ksflores-cmyk/PCIe808_SW/bom/BOM_PI7C9X3G808GP.xlsx

Sheet: BOM
Item | Categoria | Designators | Cant/placa | Descripcion | Footprint | Fabricante | MPN | Proveedor | PN proveedor | LCSC PN | Clase JLCPCB | Stock | USD unit (1 placa) | USD ext (1 placa) | USD unit (5 placas) | USD ext (5 placas) | GTQ unit (1 placa) | GTQ ext (1 placa) | GTQ ext (5 placas) | Alterno 1 (AVL) | Alterno 2 (AVL) | Estado | Confianza | Notas | URL
A01 | IC | U5 | 1 | Switch PCIe Gen3 8 puertos/8 lanes PI7C9X3G808GP | HFCBGA-196 15x15mm | Diodes Incorporated | PI7C9X3G808GPCHFCEX | DigiKey | 31-PI7C9X3G808GPCHFCEXTR-ND |  | NoEnBiblioteca | 2400 | $53.7000 | $53.70 | $53.7000 | $268.50 | Q 410.370 | Q 410.37 | Q 2051.85 |  |  | POBLADO | ALTA | RIESGO: Diodes publico PCN-2740 (EOL, 2025-06-16; ultima compra BHFCEX 2025-12-16). El sufijo CHFCEX sigue activo; DigiKey: stock de fabrica 800-2400, lead time 39 semanas, aprox. $53.70 c/u. Comprar con anticipacion; sin alterno pin-compatible. | https://www.digikey.com/en/products/detail/diodes-incorporated/PI7C9X3G808GPCHFCEX/22158428
A02 | IC | U1 | 1 | Buck TPS54KB20RZR (TI) - convertidor disenado con WEBENCH | TI RZR0016A (VQFN-HR 16) | Texas Instruments | TPS54KB20RZRR | DigiKey | 296-TPS54KB20RZRRCT-ND |  | NoEnBiblioteca | 3939 | $5.0300 | $5.03 | $5.0300 | $25.15 | Q 38.439 | Q 38.44 | Q 192.19 |  |  | POBLADO | ALTA | NOTA DE MPN: El simbolo usa TPS54KB20RZR (RZR es el codigo de paquete), pero el MPN ordenable real en TI y DigiKey lleva doble R final: TPS54KB20RZRR (RZR + R de Tape & Reel / Cut Tape). En TI Store (https://www.ti.com/product/TPS54KB20/part-details/TPS54KB20RZRR) cuesta $4.026 (1-99 uds). En DigiKey: 1-9 uds $5.03, 10+ $3.827. | https://www.digikey.com/en/products/detail/texas-instruments/TPS54KB20RZRR/22539602
A03 | IC | U2 | 1 | Buck TPS54J060RPGR (TI) - convertidor disenado con WEBENCH | TI RPG0014A (VQFN-HR 14) | Texas Instruments | TPS54J060RPGR | DigiKey | 296-TPS54J060RPGRCT-ND |  | NoEnBiblioteca | 1129 | $2.8060 | $2.81 | $2.8060 | $14.03 | Q 21.443 | Q 21.44 | Q 107.22 |  |  | POBLADO | ALTA | Stock inmediato en DigiKey: 1129 uds (escalon 10+ en DigiKey: $2.73700; en TI Store https://www.ti.com/product/TPS54J060/part-details/TPS54J060RPGR el precio de 1-99 uds es $2.806). NO sustituir. | https://www.digikey.com/en/products/detail/texas-instruments/TPS54J060RPGR/15856949
A04 | IC | U7 | 1 | Buck TPS62933FDRLR (TI) - convertidor disenado con WEBENCH | TI DRL0008A (SOT-583 8) | Texas Instruments | TPS62933FDRLR | DigiKey | 296-TPS62933FDRLRCT-ND |  | NoEnBiblioteca | 2819 | $1.7000 | $1.70 | $1.7000 | $8.50 | Q 12.991 | Q 12.99 | Q 64.96 |  |  | POBLADO | ALTA | Stock inmediato en DigiKey: 2819 uds ($1.70 para 1-9 uds, $1.242 para 10+ uds; en TI Store https://www.ti.com/product/TPS62933F/part-details/TPS62933FDRLR cuesta $1.241 de 1-99 uds). La letra F indica operacion en modo FCCM continuo; NO sustituir por variantes DRLR/ODRLR/PDRLR. | https://www.digikey.com/en/products/detail/texas-instruments/TPS62933FDRLR/16669312
A05 | IC | U3 U6 | 2 | LDO AP7361C-FGE-7 (Diodes Inc.) | DFN-8 3x3mm 0.65mm | Diodes Incorporated | AP7361C-FGE-7 | DigiKey | AP7361C-FGE-7DICT-ND |  | NoEnBiblioteca | 61948 | $0.5600 | $1.12 | $0.3027 | $3.03 | Q 4.279 | Q 8.56 | Q 23.13 |  |  | POBLADO | ALTA | Amplio stock en DigiKey (61,948 uds) y Mouser (26,023 uds, https://www.mouser.com/ProductDetail/Diodes-Incorporated/AP7361C-FGE-7). Para 1 placa (2 uds) aplica escalon 1+ ($0.56); para 5 placas (10 uds) alcanza el escalon 10+ ($0.3027). | https://www.digikey.com/en/products/detail/diodes-incorporated/AP7361C-FGE-7/5638318
A06 | IC | U4 | 1 | Hex buffer open-drain SN74LVC07A | TSSOP-14 0.65mm | Nexperia | 74LVC07APW,118 | DigiKey | 1727-74LVC07APW,118CT-ND |  | NoEnBiblioteca | 4543 | $0.2500 | $0.25 | $0.2500 | $1.25 | Q 1.910 | Q 1.91 | Q 9.55 | Texas Instruments SN74LVC07APWR (DigiKey 0 en stock, llegan 2026-11-10; TI Store ~$0.37) | Diodes Inc. 74LVC07AT14-13 (DigiKey, $0.25) | POBLADO | ALTA | Cambio: el MPN original SN74LVC07APWR tenia 0 en stock; esta pieza es pin-compatible (TSSOP-14, hex buffer open-drain, 1.65-5.5 V). | https://www.digikey.com/en/products/detail/texas-instruments/SN74LVC07APWR/377393
A07 | IC | U8 U9 | 2 | Compuerta AND 2 entradas SN74LVC1G08 | SOT-23-5 (DBV) | Texas Instruments | SN74LVC1G08DBVR | LCSC | C7666 | C7666 | Extended | 95328 | $0.0338 | $0.07 | $0.0338 | $0.34 | Q 0.258 | Q 0.52 | Q 2.58 | Nexperia 74LVC1G08GV,125 (DigiKey 1727-74LVC1G08GV,125CT-ND) | SIN_ALTERNO | POBLADO | ALTA |  | https://jlcpcb.com/partdetail/TexasInstruments-SN74LVC1G08DBVR/C7666
A08 | Discreto | Q1 | 1 | MOSFET N 2N7002A (SOT-23 estandar) | SOT-23 (TO-236AB) | Diodes Incorporated | 2N7002A-7 | Mouser | 621-2N7002A-7 |  | NoEnBiblioteca | 19346 | $0.2300 | $0.23 | $0.2300 | $1.15 | Q 1.758 | Q 1.76 | Q 8.79 | onsemi 2N7002KT1G (DigiKey 2N7002KT1GOSCT-ND) | High Diode 2N7002 (LCSC C466660) | POBLADO | ALTA | Pinout 2N7002A-7: 1=G, 2=S, 3=D. Verificado en Allegro: pads G (x=5857) y S (x=5783) arriba, D (x=5820) abajo = SOT-23 estandar girado 180 grados, compatible con G-S-D. Pendiente visual: confirmar Q1 en capa TOP. DigiKey en backorder, Mouser tiene 19,346 uds. | https://www.mouser.com/c/semiconductors/discrete-semiconductors/transistors/mosfets/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
A09 | Magnetico | L1 | 1 | Inductor Coilcraft XAL8080 680 nH (L1) - Buck WEBENCH | XAL8080 (8x8mm aprox.) | Coilcraft | XAL8080-681MED | Fabricante | XAL8080-681MED |  | NoEnBiblioteca | 450 | $1.6900 | $1.69 | $1.6900 | $8.45 | Q 12.915 | Q 12.91 | Q 64.57 |  |  | POBLADO | ALTA | NOTA DE SUFIJO COILCRAFT: En la pagina oficial de Coilcraft se informa que el sufijo de empaque B (XAL8080-681MEB) fue unificado al sufijo D (XAL8080-681MED: M=+-20%, E=RoHS Sn-Ag sobre Cu libre de halogenos, D=reel/corte disponible desde 1 ud). Precio directo Coilcraft: $1.69/ud (1+), $1.46/ud (2500+). | https://www.coilcraft.com/en-us/products/power/shielded-inductors/molded-inductor/xal/xal8080/xal8080-681/
A10 | Magnetico | L2 | 1 | Inductor Coilcraft XAL5020 560 nH (L2) - Buck WEBENCH | XAL5020 (5x5mm aprox.) | Coilcraft | XAL5020-561MEC | Fabricante | XAL5020-561MEC |  | NoEnBiblioteca | 344 | $0.7100 | $0.71 | $0.7100 | $3.55 | Q 5.426 | Q 5.43 | Q 27.13 |  |  | POBLADO | ALTA | NOTA DE SUFIJO COILCRAFT: Coilcraft unifico el codigo de empaque B a C (XAL5020-561MEC reemplaza a XAL5020-561MEB). Stock inmediato en Coilcraft: 344 uds listas para envio hoy + 664 uds adicionales el 2026-11-09. Precio unitario: $0.71 (1+). | https://www.coilcraft.com/en-us/products/power/shielded-inductors/molded-inductor/xal/xal5020/xal5020-561/
A11 | Magnetico | L3 | 1 | Inductor Coilcraft XAL7030 1.5 uH (L3) - Buck WEBENCH | XAL7030 (7x7mm aprox.) | Coilcraft | XAL7030-152MEC | LCSC | C5352784 | C5352784 | Extended | 8 | $3.0400 | $3.04 | $3.0400 | $15.20 | Q 23.231 | Q 23.23 | Q 116.16 | Coilcraft XAL7030-152MEC (Otro 69W4151) | SIN_ALTERNO | POBLADO | ALTA | Stock LCSC: solo 8 uds (alcanza 1 y 5 placas). Alterno: Coilcraft directo/Newark 69W4151, mismo MPN XAL7030-152MEC. Isat 23.5 A, DCR 7.6 mOhm. | https://www.lcsc.com/product-detail/power-inductors_coilcraft-xal7030-152mec_C5352784.html
A12 | Magnetico | BD1 BD2 BD3 BD4 BD5 BD6 | 6 | Ferrita HI1812V101R-10 (100 ohm @100 MHz) | 1812 (L1812) | Laird-Signal Integrity Products | HI1812V101R-10 | DigiKey | 240-2543-1-ND | C2442066 | Extended | 189703 | $0.5600 | $3.36 | $0.4500 | $13.50 | Q 4.279 | Q 25.68 | Q 103.17 | Wurth Elektronik 74279226101 (DigiKey 732-74279226101CT-ND) | Wurth Elektronik 78279226101 (DigiKey 732-78279226101CT-ND) | POBLADO | ALTA | JLCPCB/LCSC C2442066 a $0.3702 (Extended, 11,889 uds) es mas barato que DigiKey; precio mostrado = DigiKey. Alternos Wurth 100 ohm/100 MHz/8 A con menor DCR (6 mOhm). | https://www.digikey.com/en/products/detail/laird-signal-integrity-products/HI1812V101R-10/1015967
A13 | Conector | J1 J2 J3 J4 | 4 | Conector M.2 (NGFF) Key M, para SSD 2280 | M2_M_2280_KF (conector SMD 67 pos, Key M, altura a definir) | TE Connectivity | 1-2199230-4 | DigiKey | 17-1-2199230-4CT-ND |  | NoEnBiblioteca | 4248 | $1.9500 | $7.80 | $1.7910 | $35.82 | Q 14.902 | Q 59.61 | Q 273.73 | TE Connectivity 1-2199230-5 (DigiKey A115905CT-ND) | Minlenda MLD-NGFF-M-3.2H (LCSC C52766481) | POBLADO | ALTA | MPN corregido: 1-2199230-4 es Key M (SSD 2280), 4.2 mm, 10 uin Au. 2199230-4 (sin prefijo) es Key E, NO usar. Alterno JLCPCB para 3.2 mm: Minlenda MLD-NGFF-M-3.2H (C52766481); altura 4.2 mm define el standoff. | https://www.digikey.com/en/products/detail/te-connectivity-amp-connectors/1-2199230-4/7039236
A13B | Mecanico | J1 J2 J3 J4 (1 por conector, a 80 mm del conector) | 4 | Standoff SMD (poste) para modulos M.2 2280 + tornillo M2 | Standoff SMD M2, altura igual a la del conector M.2 elegido en A13 | JAE Electronics | SM3ZS067U410-NUT1-R1200 | DigiKey | 670-2865-1-ND |  | NoEnBiblioteca | 131543 | $1.2900 | $0.00 | $1.0950 | $0.00 | Q 9.858 | Q 0.00 | Q 0.00 | Wurth Elektronik 9774025243R (DigiKey 732-9774025243RCT-ND) | SIN_ALTERNO | OPCIONAL | ALTA | NO incluido en total. El footprint de J4 trae un agujero PTH de 3.2 mm con pad de 6.0 mm a la posicion 2280 (MH1) y pads SMD MP1/MP2 de 1.2x2.75 mm, no un pad SMD de standoff: la tuerca SMD JAE puede no coincidir con ese agujero. Verificar contra el plano del conector antes de comprar; es herreria opcional, no afecta el PCB. | https://www.digikey.com/en/products/detail/jae-electronics/SM3ZS067U410-NUT1-R1200/5955846
A14 | Conector | P1 | 1 | Conector de potencia 4 pines vertical/90 grados "PWR-4P-90" (P1) | PWR-4P-90 | Molex | 0015244441 | DigiKey |  |  | NoAplica |  |  | $0.00 |  | $0.00 |  | Q 0.00 | Q 0.00 | Molex 0039301040 (Mini-Fit Jr 2x2, paso 4.2 mm: NO coincide con 5.08 mm) | Molex 0022053041 (KK 254, paso 2.54 mm: NO coincide con 5.08 mm) | POR_DEFINIR | MEDIA | Medido en Allegro: P1 tiene 4 pads a 5.08 mm de paso (pads 2.54x4.00 mm), pin1=12V, pin2=GND, pin3=GND, pin4=5V. Candidato: Molex 15-24-4441 (disk power, 5.08 mm, 90 grados). Precio y PN DigiKey sin verificar; el footprint declara pads SMD y la pieza es de agujero pasante: confirmar contra el plano. Excluido del total. | https://www.digikey.com/en/products/detail/molex/0039301040/561079
A15 | Conector | PWR1 | 1 | Conector de potencia PCIe 6 pines Molex 45558-0003 (PWR1) | 455580003 | Molex | 0455580003 | DigiKey | WM10869-ND |  | NoEnBiblioteca | 74992 | $1.1700 | $1.17 | $1.1700 | $5.85 | Q 8.941 | Q 8.94 | Q 44.71 |  |  | POBLADO | ALTA | MPN confirmado en Molex y DigiKey (0455580003 = 45558-0003). Stock inmediato en DigiKey: 74,992 uds a $1.17/ud. | https://www.digikey.com/en/products/detail/molex/0455580003/3311349
A16 | LED | DS1 DS2 | 2 | LED verde 0805 | LED-0805 | Hubei KENTO Elec | KT-0805G | LCSC | C2297 | C2297 | Basic | 1977662 | $0.0164 | $0.03 | $0.0164 | $0.16 | Q 0.125 | Q 0.25 | Q 1.25 |  |  | POBLADO | ALTA | Pieza JLCPCB Basic (C2297) con 1,977,662 uds en stock ($0.0164/ud en cantidades bajas, $0.0101/ud en carrete). Verificar polaridad del catodo en el footprint LED-0805. | https://jlcpcb.com/partdetail/C2297
A17 | LED | DS3 DS4 DS5 DS6 | 4 | LED rojo 0805 | LED-0805 | Foshan NationStar Optoelectronics | NCD0805R1 | LCSC | C84256 | C84256 | Basic | 2049152 | $0.0089 | $0.04 | $0.0089 | $0.18 | Q 0.068 | Q 0.27 | Q 1.36 | Hubei KENTO Elec KT-0805R (LCSC C2295) | SIN_ALTERNO | POBLADO | ALTA |  | https://jlcpcb.com/partdetail/85425-NCD0805R1/C84256
A18 | Mecanico | TP1 TP2 TP3 TP4 | 4 | Punto de prueba TESTPIN25 (pad de cobre de 25 mil, sin pieza) | Pad desnudo 25 mil (0.635 mm) |  | (sin pieza) |  |  |  | NoAplica |  |  | $0.00 |  | $0.00 |  | Q 0.00 | Q 0.00 |  |  | SIN_PIEZA | ALTA | Test points: pad desnudo de cobre (TESTPIN25), sin componente. Excluir de pick&place. | NO_APLICABLE
B01 | Cap | C1 C2 C13 C14 C15 C16 C66 C67 C114 C115 C116 C117 C118 C119 C120 C121 | 16 | Capacitor 0.22 uF | 0402 | Samsung Electro-Mechanics | CL05B224KO5NNNC | LCSC | C16772 | C16772 | Basic | 1200932 | $0.0049 | $0.08 | $0.0049 | $0.39 | Q 0.037 | Q 0.60 | Q 3.00 | CCTC TCC0402X7R224K160AT (LCSC C696846) | FOJAN FCC0402B224K100AT (LCSC C54619721) | POBLADO | ALTA | Pieza JLCPCB Basic (C16772) con 1,200,932 uds en stock ($0.0049/ud base; $0.0033/ud en 1500+). Cumple holgadamente acople AC PCIe Gen3 (16V X7R +-10% en 0402). Alternos verificados en stock: CCTC C696846 (151,976 uds, $0.0039) y FOJAN C54619721 (3,885 uds, $0.0034). | https://jlcpcb.com/partdetail/CL05B224KO5NNNC/C16772
B02 | Cap | C74 C83 C85 C90 C97 C101 C102 C105 C108 C109 C112 | 11 | Capacitor 10 uF 6.3 V | 0402 | Samsung Electro-Mechanics | CL05A106MQ5NUNC | LCSC | C15525 | C15525 | Basic | 9522813 | $0.0257 | $0.28 | $0.0257 | $1.41 | Q 0.196 | Q 2.16 | Q 10.80 | FH (Guangdong Fenghua Advanced Tech) 0402X106M100NT (LCSC C2846677) | YAGEO CC0402MPX5R5BB106 (LCSC C1856527) | POBLADO | ALTA | Pieza JLCPCB Basic (C15525) con 9,522,813 uds en stock ($0.0257/ud base; $0.0163 en 3000+). DC bias: En encapsulado 0402, un MLCC de 10 uF 6.3V X5R retiene ~5.5-6.5 uF efectivos a 0.95 V (rieles VDDC/VP) y cae a ~2.0-2.5 uF efectivos a 3.3 V. Alterno FH C2846677 es de 10V (429,835 en stock, $0.0611). | https://jlcpcb.com/partdetail/16204-CL05A106MQ5NUNC/C15525
B03 | Cap | C72 C73 C78 C82 C84 C86 C87 C93 C103 C107 C111 | 11 | Capacitor 4.7 uF 6.3 V | 0402 | Samsung Electro-Mechanics | CL05A475MP5NRNC | LCSC | C23733 | C23733 | Basic | 2641074 | $0.0153 | $0.17 | $0.0153 | $0.84 | Q 0.117 | Q 1.29 | Q 6.43 | YAGEO CC0402MRX5R5BB475 (LCSC C106859) | CCTC TCC0402X5R475M6R3AT (LCSC C380302) | POBLADO | ALTA | Pieza JLCPCB Basic (C23733, 10V X5R) con 2,641,074 uds en stock ($0.0153/ud base; $0.0104 en 1500+). ALERTA DC BIAS: A 0.95 V retiene ~3.2-3.6 uF efectivos (~70-75%); a 1.8 V retiene ~2.4 uF efectivos; a 3.3 V cae a ~1.5 uF efectivos. Alterno Yageo C106859 (6.3V, 49,031 uds en stock, $0.0306). | https://jlcpcb.com/partdetail/CL05A475MP5NRNC/C23733
B04 | Cap | C3 C5 C7 C9 C11 C36 C44 C68 C69 C70 C113 | 11 | Capacitor 22 uF 25 V | 1206 | Samsung Electro-Mechanics | CL31A226KAHNNNE | LCSC | C12891 | C12891 | Basic | 1614768 | $0.1198 | $1.32 | $0.1198 | $6.59 | Q 0.915 | Q 10.07 | Q 50.35 | FH (Guangdong Fenghua Advanced Tech) 1206X226K250NT (LCSC C5162260) | FH (Guangdong Fenghua Advanced Tech) 1206X226M250NT (LCSC C2858005) | POBLADO | ALTA | 22 uF 25 V en 1206 a 12 V pierde capacidad por DC bias (derating); capacidad efectiva menor que la nominal. | https://jlcpcb.com/partdetail/13537-CL31A226KAHNNNE/C12891
B05 | Cap | C4 C6 C8 C10 C12 C37 C40 C41 C42 C45 C48 C49 C52 C61 C62 C64 C65 C71 C75 C76 C77 C79 C80 C81 C88 C89 C91 C92 C94 C95 C96 C98 C99 C100 C104 C106 C110 | 37 | Capacitor 0.1 uF (100 nF) | 0402 | Samsung Electro-Mechanics | CL05B104KO5NNNC | LCSC | C1525 | C1525 | Basic | 32493126 | $0.0031 | $0.11 | $0.0031 | $0.57 | Q 0.024 | Q 0.88 | Q 4.38 | Samsung Electro-Mechanics CL05B104KB54PNC (LCSC C307331) | YAGEO CC0402KRX7R6BB104 (LCSC C309458) | POBLADO | ALTA | Pieza JLCPCB Basic (C1525) con 32,493,126 uds en stock ($0.0031/ud base; $0.0020 en 3000+). Tambien existe la version Basic de 50V Samsung CL05B104KB54PNC (C307331). Nota: el alterno Yageo C309458 (97,250 en stock, $0.0019) y Murata GRM155R71A104KA01D (C71687, 9,951 en stock, $0.0130) son de 10V. | https://jlcpcb.com/partdetail/1877-CL05B104KO5NNNC/C1525
B06 | Cap | C39 C47 C63 | 3 | Capacitor 10 uF 10 V | 0603 | Samsung Electro-Mechanics | CL10A106MA8NRNC | LCSC | C96446 | C96446 | Basic | 6857661 | $0.0352 | $0.11 | $0.0352 | $0.53 | Q 0.269 | Q 0.81 | Q 4.03 | FH (Guangdong Fenghua Advanced Tech) 0603X106K160NT (LCSC C70225) | SIN_ALTERNO | POBLADO | ALTA |  | https://jlcpcb.com/partdetail/97651-CL10A106MA8NRNC/C96446
B07 | Cap | C33 C53 C54 C58 C59 C60 | 6 | Capacitor 47 uF 6.3 V | 0805 | Samsung Electro-Mechanics | CL21A476MQYNNNE | LCSC | C16780 | C16780 | Basic | 1038806 | $0.1021 | $0.61 | $0.1021 | $3.06 | Q 0.780 | Q 4.68 | Q 23.41 | CCTC TCC0805X5R476K6R3FT (LCSC C50767263) | Wurth Elektronik 885012107006 (LCSC C5553114) | POBLADO | ALTA | Pieza JLCPCB Basic (C16780) con 1,038,806 uds en stock ($0.1021/ud base; $0.0686 en 300+). Alterno CCTC C50767263 es +-10% con 15,567 uds en stock ($0.1326/ud). DC bias: Un MLCC 47 uF 6.3V en 0805 operando a 0.95 V (salida Buck C33 y filtrado VDDC/VP) retiene ~28-33 uF efectivos; a 3.3 V cae a ~10-14 uF efectivos. | https://jlcpcb.com/partdetail/17464-CL21A476MQYNNNE/C16780
B08 | Cap | C55 | 1 | Capacitor 100 pF 50 V C0G/NP0 | 0402 | FH (Guangdong Fenghua Advanced Tech) | 0402CG101J500NT | LCSC | C1546 | C1546 | Basic | 2700615 | $0.0030 | $0.003 | $0.0030 | $0.01 | Q 0.023 | Q 0.02 | Q 0.11 | Murata Electronics GRM1555C1H101JA01D (LCSC C77177) | SIN_ALTERNO | POBLADO | ALTA |  | https://jlcpcb.com/partdetail/1898-0402CG101J500NT/C1546
B09 | Cap | C20 C23 | 2 | Capacitor 1 uF 25 V | 0402 | Samsung Electro-Mechanics | CL05A105KA5NQNC | LCSC | C52923 | C52923 | Basic | 9868868 | $0.0063 | $0.01 | $0.0063 | $0.06 | Q 0.048 | Q 0.10 | Q 0.48 | FH (Guangdong Fenghua Advanced Tech) 0402X105K250NT (LCSC C967571) | CCTC TCC0402X5R105K250AT (LCSC C5359886) | POBLADO | ALTA | Pieza JLCPCB Basic (C52923) con 9,868,868 uds en stock ($0.0063/ud). Alternos verificados en JLCPCB con amplio stock: FH C967571 (97,073 uds, $0.0128) y CCTC C5359886 (1,604,590 uds, $0.0047). | https://jlcpcb.com/partdetail/53938-CL05A105KA5NQNC/C52923
B10 | Cap | C43 | 1 | Capacitor 22 nF 16 V | 0402 | FH (Guangdong Fenghua Advanced Tech) | 0402B223K500NT | LCSC | C1532 | C1532 | Basic | 550069 | $0.0049 | $0.0049 | $0.0049 | $0.02 | Q 0.037 | Q 0.04 | Q 0.19 | Samsung Electro-Mechanics CL05B223KA5VPNC (LCSC C307334) | KEMET C0402C223J5RACTU (LCSC C22413859) | POBLADO | ALTA | Pieza JLCPCB Basic (C1532, 50V X7R) con 550,069 uds en stock ($0.0049/ud base; $0.0032 en 3000+). Supera el requisito de >=16 V. | https://jlcpcb.com/partdetail/1884-0402B223K500NT/C1532
B11 | Cap | C34 | 1 | Capacitor 270 nF 10 V | 0402 | Cal-Chip Electronics, Inc. | GMC04X5R274K10NT | DigiKey | 4713-GMC04X5R274K10NT-ND |  | NoEnBiblioteca | 40000 | $0.5100 | $0.51 | $0.5100 | $2.55 | Q 3.897 | Q 3.90 | Q 19.49 | Cal-Chip Electronics, Inc. GMC04X5R274K25NT (DigiKey 4713-GMC04X5R274K25NTTR-ND) | Murata Electronics GRM155R61A274KE15D (DigiKey 490-GRM155R61A274KE15D-ND) | POBLADO | MEDIA | Valor poco comun (270 nF, 10 V X5R). Precio tomado de la version de 25 V de la misma pagina (MEDIA). | https://www.digikey.com/en/products/detail/cal-chip-electronics-inc/GMC04X5R274K10NT/27903922
B12 | Cap | C31 | 1 | Capacitor 33 nF 10 V | 0402 | CCTC | TCC0402X7R333K250AT | LCSC | C466238 | C466238 | Extended | 9714 | $0.0022 | $0.0022 | $0.0022 | $0.01 | Q 0.017 | Q 0.02 | Q 0.08 | Murata Electronics GCM155R71H333KE02D (LCSC C126535) | FOJAN FCC0402B333K160AT (LCSC C5137555) | POBLADO | ALTA | En stock en JLCPCB: CCTC C466238 (25V X7R +-10%, 9,714 uds, $0.0022/ud base; $0.0014 en 3000+) y alterno automotriz Murata GCM155R71H333KE02D (C126535, 50V X7R +-10%, 24,351 uds en stock, $0.0203/ud). | https://jlcpcb.com/partdetail/CCTC-TCC0402X7R333K250AT/C466238
B13 | Cap | C24 C25 C51 | 3 | Capacitor 100 nF 25 V | 0603 | YAGEO | CC0603KRX7R9BB104 | LCSC | C14663 | C14663 | Basic | 34214040 | $0.0155 | $0.05 | $0.0155 | $0.23 | Q 0.118 | Q 0.36 | Q 1.78 | Samsung Electro-Mechanics CL10B104KB8NNNC (LCSC C1591) | FH (Guangdong Fenghua Advanced Tech) 0603B104K500NT (LCSC C30926) | POBLADO | ALTA | Pieza JLCPCB Basic (C14663, 50V X7R) con 34,214,040 uds en stock ($0.0155/ud base; $0.0102 en 1500+). Alternos verificados con millones en stock: Samsung C1591 (50V, 3,404,212 uds, $0.0071), Samsung C1590 (25V, 501,553 uds, $0.0143) y FH C30926 (50V, 4,235,600 uds, $0.0049). | https://jlcpcb.com/partdetail/Yageo-CC0603KRX7R9BB104/C14663
B14 | Cap | C17 | 1 | Capacitor 330 nF 10 V | 0603 | FH (Guangdong Fenghua Advanced Tech) | 0603B334K250NT | LCSC | C1615 | C1615 | Extended | 102029 | $0.0169 | $0.02 | $0.0169 | $0.08 | Q 0.129 | Q 0.13 | Q 0.65 | YAGEO CC0603KRX7R8BB334 (LCSC C107070) | Kyocera AVX 06035C334KAT2A (LCSC C5372022) | POBLADO | ALTA | Disponibilidad confirmada en 0603 X7R 25V: FH C1615 tiene 102,029 uds en stock en JLCPCB ($0.0169/ud) y el alterno Yageo CC0603KRX7R8BB334 (C107070) tiene 63,069 uds en stock ($0.0155/ud). Evitar CCTC C48986350 porque solo tiene 4 uds en stock. | https://jlcpcb.com/partdetail/1967-0603B334K250NT/C1615
B15 | Cap | C26 C32 | 2 | Capacitor 100 nF 25 V | 0805 | YAGEO | CC0805KRX7R9BB104 | LCSC | C49678 | C49678 | Basic | 28065147 | $0.0206 | $0.04 | $0.0206 | $0.21 | Q 0.157 | Q 0.31 | Q 1.57 | Samsung Electro-Mechanics CL21B104KCFNNNE (LCSC C28233) | CCTC TCC0805X7R104K101DTM (LCSC C51902255) | POBLADO | ALTA | Pieza JLCPCB Basic (C49678, 50V X7R) con 28,065,147 uds en stock ($0.0206/ud base; $0.0155 en 200+). Alternos verificados: Samsung C28233 (100V X7R, 3,273,359 uds en stock, $0.0185) y CCTC C51902255 (100V X7R, 7,670 uds, $0.0309). | https://jlcpcb.com/partdetail/YAGEO-CC0805KRX7R9BB104/C49678
B16 | Cap | C50 | 1 | Capacitor 10 uF 10 V X5R | 0805 | Samsung Electro-Mechanics | CL21A106KAYNNNE | LCSC | C15850 | C15850 | Basic | 7304027 | $0.0397 | $0.04 | $0.0397 | $0.20 | Q 0.303 | Q 0.30 | Q 1.52 | CCTC TCC0805X5R106K160FT (LCSC C380332) | FH (Guangdong Fenghua Advanced Tech) 0805X106K250NT (LCSC C40894) | POBLADO | ALTA | Pieza JLCPCB Basic (C15850, 25V X5R +-10%) con 7,304,027 uds en stock ($0.0397/ud base; $0.0313 en 200+). Alternos en stock: CCTC C380332 (16V, 65,691 uds, $0.0351) y FH C40894 (25V, 244,723 uds, $0.1098). DC bias: En 0805 25V, a 3.3 V retiene ~6.5-7.5 uF efectivos; a 5 V retiene ~5.0-6.0 uF efectivos. | https://jlcpcb.com/partdetail/16532-CL21A106KAYNNNE/C15850
B17 | Cap | C27 C38 | 2 | Capacitor 2.2 uF 10 V | 0805 | Samsung Electro-Mechanics | CL21A225KBQNNNE | LCSC | C377773 | C377773 | Basic | 795697 | $0.0393 | $0.08 | $0.0393 | $0.39 | Q 0.300 | Q 0.60 | Q 3.00 | FH (Guangdong Fenghua Advanced Tech) 0805X225K250NT (LCSC C105486) | CCTC TCC0805X7R225K160FT (LCSC C380348) | POBLADO | ALTA | Pieza JLCPCB Basic (C377773, 50V X5R) con 795,697 uds en stock ($0.0393/ud base; $0.0287 en 300+). Evitar CCTC C380348 porque solo tiene 4 uds en stock. | https://jlcpcb.com/partdetail/350246-CL21A225KBQNNNE/C377773
B18 | Cap | C18 C19 C21 C22 | 4 | Capacitor 4.7 uF 50 V X7R | 1206 | FH (Guangdong Fenghua Advanced Tech) | 1206B475K500NT | LCSC | C29823 | C29823 | Basic | 690395 | $0.0697 | $0.28 | $0.0697 | $1.39 | Q 0.533 | Q 2.13 | Q 10.65 | Samsung Electro-Mechanics CL31B475KBHNNNE (LCSC C51205) | Murata Electronics GRM31CR71H475KA12K (LCSC C3843658) | POBLADO | ALTA | Excelente disponibilidad en 1206 50V X7R (capacitores de entrada de los Bucks a 12V): FH C29823 tiene 690,395 uds en stock ($0.0697/ud), con alternos Samsung C51205 y Murata C3843658. | https://jlcpcb.com/partdetail/30577-1206B475K500NT/C29823
B19 | Cap | C46 | 1 | Capacitor 100 uF 6.3 V X6S | 1210 | Samsung Electro-Mechanics | CL32A107MQVNNWE | LCSC | C16196520 | C16196520 | Extended | 2763 | $0.6969 | $0.70 | $0.6969 | $3.48 | Q 5.326 | Q 5.33 | Q 26.63 | Murata Electronics GRM32EC70J107ME15L (LCSC C393041) | CCTC TCC1210X5R107M100MT (LCSC C53327005) | POBLADO | ALTA | ALERTA NRND/STOCK EN REFERENCIA MURATA: En DigiKey, Murata GRM32ER60J107ME20L tiene 0 stock ($1.42) y su variante GRM32ER60J107ME20K (102,498 en stock en DigiKey, $1.76/ud) esta marcada como NRND (Not Recommended for New Design). En JLCPCB (clase Extended) hay excelente stock activo en Samsung CL32A107MQVNNWE (C16196520, 6.3V X5R, 2,763 uds, $0.6969), Murata GRM32EC70J107ME15L (C393041, 6.3V X7S). | https://jlcpcb.com/partdetail/17321598-CL32A107MQVNNWE/C16196520
B20 | Cap | C35 | 1 | Capacitor 22 uF 16 V X5R | 1210 | Samsung Electro-Mechanics | CL32A226MOJNNNE | LCSC | C100086 | C100086 | Extended | 448 | $0.3014 | $0.30 | $0.3014 | $1.51 | Q 2.303 | Q 2.30 | Q 11.52 | AIDE CAPACITOR 1210X5R226K350NT (LCSC C49326801) | CCTC TCC1210X5R226K250MT (LCSC C48543646) | POBLADO | ALTA | Clase Extended en JLCPCB: Samsung CL32A226MOJNNNE (C100086, 16V X5R, 448 uds en stock, $0.3014/ud) y alterno de mayor voltaje AIDE 1210X5R226K350NT (C49326801, 35V X5R +-10%, 425 uds en stock, $0.2464/ud). DC bias: En paquete 1210 a 3.3 V retiene ~14-16 uF efectivos. | https://jlcpcb.com/partdetail/101300-CL32A226MOJNNNE/C100086
B21 | Cap | C28 C29 C30 | 3 | Capacitor 47 uF 16 V X5R | 1210 | Samwha Capacitor | CS3225X5R476K160NRL | LCSC | C2918513 | C2918513 | Extended | 21763 | $0.2233 | $0.67 | $0.2233 | $3.35 | Q 1.706 | Q 5.12 | Q 25.60 | Taiyo Yuden EMK325ABJ476MM8P (LCSC C20241892) | CCTC TCC1210X5R476M160MT (LCSC C53327077) | POBLADO | ALTA | Confirmada existencia real en 1210 16V X5R: Samwha CS3225X5R476K160NRL (C2918513, +-10%) tiene 21,763 uds en stock en JLCPCB a $0.2233/ud. Alternos: Taiyo Yuden EMK325ABJ476MM8P (C20241892) y CCTC TCC1210X5R476M160MT (C53327077). DC bias: A 3.3 V (salida del Buck 1, C28..C30) retiene ~22-28 uF efectivos por unidad. | https://jlcpcb.com/partdetail/3220365-CS3225X5R476K160NRL/C2918513
B22 | Cap | C56 C57 | 2 | Capacitor 100 uF 6.3 V (NO POBLAR: prefijo X_ en el simbolo) | 1206 | HRE | CGA1206X5R107M100NT | LCSC | C6119961 | C6119961 | Extended | 36921 | $0.1929 | $0.00 | $0.1929 | $0.00 | Q 1.474 | Q 0.00 | Q 0.00 | Samsung Electro-Mechanics CL31A107MQHNNWE (DigiKey 1276-CL31A107MQHNNWETR-ND) | TDK Corporation C3216X5R0J107M160AB (DigiKey 445-6008-2-ND) | DNP | ALTA | NO POBLAR (DNP). Pieza clase Extended en JLCPCB: HRE CGA1206X5R107M100NT (C6119961, 100uF 10V X5R 1206) tiene 36,921 uds en stock ($0.1929/ud base; $0.1491 en 50+). En DigiKey y JLCPCB, Samsung CL31A107MQHNNNE (C9900065869) y Murata GRM31CR60J107ME39K/L tienen 0 stock hoy (lead time 61 semanas); hay reemplazo activo de Samsung con 251,957 uds en stock. X_ en el simbolo (C56, C57) = no poblado. 100 uF 1206 X5R 6.3 V: considerar derating por DC bias. | https://jlcpcb.com/partdetail/HRE-CGA1206X5R107M100NT/C6119961
B30 | Res | R1 R2 R3 R21 R25 R26 R29 R30 R31 R32 R33 R36 R45 R46 R47 R48 R49 R51 R52 | 19 | Resistencia 0 ohm (puente) | 0402 | UNI-ROYAL (Uniroyal Elec) | 0402WGF0000TCE | LCSC | C17168 | C17168 | Basic | 14154629 | $0.0011 | $0.02 | $0.0011 | $0.10 | Q 0.008 | Q 0.16 | Q 0.80 | YAGEO AC0402JR-070RL (LCSC C138289) | FH (Guangdong Fenghua Advanced Tech) RC-02000FT (LCSC C140225) | POBLADO | ALTA | Pieza JLCPCB Basic (C17168) con 14,154,629 uds en stock ($0.0011/ud base; $0.0007 en 3000+). Alternos con >1M en stock: Yageo AC0402JR-070RL (C138289, 1,905,830 uds) y FH RC-02000FT (C140225, 1,225,937 uds). | https://jlcpcb.com/partdetail/C17168
B31 | Res | R38 | 1 | Resistencia 4.7 kohm | 0402 | UNI-ROYAL (Uniroyal Elec) | 0402WGF4701TCE | LCSC | C25900 | C25900 | Basic | n/v | $0.0014 | $0.0014 | $0.0014 | $0.01 | Q 0.011 | Q 0.01 | Q 0.05 | SIN_ALTERNO | SIN_ALTERNO | POBLADO | ALTA | Pieza JLCPCB Basic (C25900). 4.7 kohm limita el LED de 12 V a ~2 mA y ~21 mW, dentro de los 62.5 mW del 0402. | https://jlcpcb.com/partdetail/0402WGF4701TCE/C25900
B32 | Res | R28 R34 R39 R40 R41 RD6 RD8 RD10 RD11 RD12 RD13 RD14 RD15 RD16 RD17 RD18 | 16 | Resistencia 330 ohm | 0402 | UNI-ROYAL (Uniroyal Elec) | 0402WGF3300TCE | LCSC | C25104 | C25104 | Basic | 2167998 | $0.0011 | $0.02 | $0.0011 | $0.09 | Q 0.008 | Q 0.13 | Q 0.67 |  |  | POBLADO | ALTA | Pieza JLCPCB Basic (C25104) con 2,167,998 uds en stock ($0.0011/ud base; $0.0008 en 3000+). | https://jlcpcb.com/partdetail/25847-0402WGF3300TCE/C25104
B33 | Res | R14 R15 R16 R17 R24 R42 RP1 RP2 RP3 RP4 RP5 RP6 RP7 RP8 RP9 RP10 RP11 RP12 RP13 RP14 RP15 | 21 | Resistencia 5.1 kohm | 0402 | UNI-ROYAL (Uniroyal Elec) | 0402WGF5101TCE | LCSC | C25905 | C25905 | Basic | 5060970 | $0.0023 | $0.05 | $0.0023 | $0.24 | Q 0.018 | Q 0.37 | Q 1.85 |  |  | POBLADO | ALTA | Pieza JLCPCB Basic (C25905) con 5,060,970 uds en stock ($0.0023/ud base; $0.0015 en 3000+). | https://jlcpcb.com/partdetail/0402WGF5101TCE/C25905
B34 | Res | R11 R12 | 2 | Resistencia 680 ohm | 0402 | UNI-ROYAL (Uniroyal Elec) | 0402WGF6800TCE | LCSC | C25130 | C25130 | Basic | 691 | $0.0015 | $0.003 | $0.0015 | $0.01 | Q 0.011 | Q 0.02 | Q 0.11 | YAGEO RC0402FR-07680RL (LCSC C137948) | SIN_ALTERNO | POBLADO | ALTA |  | https://jlcpcb.com/partdetail/25873-0402WGF6800TCE/C25130
B35 | Res | R22 R35 | 2 | Resistencia 20 kohm 1% | 0402 | UNI-ROYAL (Uniroyal Elec) | 0402WGF2002TCE | LCSC | C25765 | C25765 | Basic | 2868709 | $0.0011 | $0.0022 | $0.0011 | $0.01 | Q 0.008 | Q 0.02 | Q 0.08 |  |  | POBLADO | ALTA | Pieza JLCPCB Basic (C25765) con 2,868,709 uds en stock ($0.0007/ud en 3000+). | https://jlcpcb.com/partdetail/26508-0402WGF2002TCE/C25765
B36 | Res | R37 | 1 | Resistencia 25 kohm 1% | 0402 | Vishay | CRCW040224K9FKTE | LCSC | C4229427 | C4229427 | Extended |  |  | $0.00 |  | $0.00 |  | Q 0.00 | Q 0.00 | Vishay PNM0402E2502BST1 25.0 k 0.1% (LCSC C4219672, $3.3672 c/u, stock 176) |  | POBLADO | MEDIA | 25.0 kohm no es valor E96. Se usa 24.9 kohm 1% (-0.4% del nominal, dentro de tolerancia). Precio de C4229427 sin verificar (resistencia 0402 comun, centavos). Si el profesor exige 25.0 k exacto, usar el alterno de $3.37. | https://jlcpcb.com/partdetail/VishayIntertech-PNM0402E2502BST1/C4219672
B37 | Res | R23 | 1 | Resistencia 3.9 kohm 1% | 0402 | ROHM Semiconductor | MCR01MZPF3901 | LCSC | C525581 | C525581 | Extended | 1540 | $0.0028 | $0.0028 | $0.0028 | $0.01 | Q 0.021 | Q 0.02 | Q 0.11 |  |  | POBLADO | ALTA | En stock en JLCPCB: ROHM MCR01MZPF3901 (C525581, 1,540 uds en stock, $0.0028/ud). | https://jlcpcb.com/partdetail/ROHMSemicon-MCR01MZPF3901/C525581
B38 | Res | R50 | 1 | Resistencia 200 ohm 1% | 0402 | UNI-ROYAL (Uniroyal Elec) | 0402WGF2000TCE | LCSC | C25087 | C25087 | Basic | 1754698 | $0.0029 | $0.0029 | $0.0029 | $0.01 | Q 0.022 | Q 0.02 | Q 0.11 |  |  | POBLADO | ALTA | Pieza JLCPCB Basic (C25087) con 1,754,698 uds en stock ($0.0029/ud base; $0.0019 en 3000+). | https://jlcpcb.com/partdetail/25830-0402WGF2000TCE/C25087
B39 | Res | R6 | 1 | Resistencia 100 kohm 1% | 0402 | UNI-ROYAL (Uniroyal Elec) | 0402WGF1003TCE | LCSC | C25741 | C25741 | Basic | 7345955 | $0.0014 | $0.0014 | $0.0014 | $0.01 | Q 0.011 | Q 0.01 | Q 0.05 | YAGEO RC0402FR-07100KL (LCSC C60491) | TyoHM RMC 0402 100K F N (LCSC C269673) | POBLADO | ALTA | Pieza JLCPCB Basic (C25741) con 7,345,955 uds en stock ($0.0010 en 3000+). Alterno Yageo RC0402FR-07100KL (C60491) tiene 15,851,079 uds en stock ($0.0021/ud). | https://jlcpcb.com/partdetail/0402WGF1003TCE/C25741
B40 | Res | R20 | 1 | Resistencia 10 kohm 0.1% | 0402 | YAGEO | RT0402BRD0710KL | LCSC | C190095 | C190095 | Extended | 427935 | $0.0255 | $0.03 | $0.0255 | $0.13 | Q 0.195 | Q 0.19 | Q 0.97 |  |  | POBLADO | ALTA | Cumple exactamente tolerancia +-0.1% y TCR +-25 ppm/C (Yageo serie RT0402). Amplio stock en JLCPCB: 427,935 uds a $0.0255/ud. | https://jlcpcb.com/partdetail/YAGEO-RT0402BRD0710KL/C190095
B41 | Res | R7 R10 R43 | 3 | Resistencia 10 kohm 1% | 0402 | UNI-ROYAL (Uniroyal Elec) | 0402WGF1002TCE | LCSC | C25744 | C25744 | Basic | 16504869 | $0.0018 | $0.01 | $0.0018 | $0.03 | Q 0.014 | Q 0.04 | Q 0.21 | YAGEO RC0402FR-0710KL (LCSC C60490) | SIN_ALTERNO | POBLADO | ALTA |  | https://jlcpcb.com/partdetail/C25744
B42 | Res | R5 | 1 | Resistencia 26.7 kohm 1% | 0402 | Ever Ohms Tech | CR0402F26K7Q10Z | LCSC | C2835756 | C2835756 | Extended | SIN_VERIFICAR_STOCK |  | $0.00 |  | $0.00 |  | Q 0.00 | Q 0.00 | YAGEO RC0402FR-0726K7L (DigiKey 311-26.7KLRCT-ND) | YAGEO AC0402FR-0726K7L (DigiKey 13-AC0402FR-0726K7LCT-ND) | POBLADO | MEDIA | Precio y stock de C2835756 sin verificar (MEDIA); disponibles Yageo RC0402FR-0726K7L y AC0402FR-0726K7L en DigiKey. Costo unitario esperado: centavos. | https://jlcpcb.com/partdetail/Ever_OhmsTech-CR0402F26K7Q10Z/C2835756
B43 | Res | R9 | 1 | Resistencia 4.99 kohm 1% | 0402 | Viking Tech | ARG02FTC4991 | LCSC | C284594 | C284594 | Extended | 9519 | $0.0050 | $0.01 | $0.0050 | $0.03 | Q 0.038 | Q 0.04 | Q 0.19 | KOA Speer Electronics, Inc. RK73H1ERTTP4991F (LCSC C2599032) | SIN_ALTERNO | POBLADO | ALTA |  | https://jlcpcb.com/partdetail/VikingTech-ARG02FTC4991/C284594
B44 | Res | R19 | 1 | Resistencia 5.49 kohm 1% | 0402 | FH (Guangdong Fenghua Advanced Tech) | RC-02K5491FT | LCSC | C324905 | C324905 | Extended | 9421 | $0.0030 | $0.003 | $0.0030 | $0.01 | Q 0.023 | Q 0.02 | Q 0.11 | GiantOhm GR0402F5K49TAG00 (LCSC C49653853) | SIN_ALTERNO | POBLADO | ALTA |  | https://jlcpcb.com/partdetail/305430-RC02K5491FT/C324905
B45 | Res | R8 | 1 | Resistencia 5.76 kohm 1% | 0402 | Vishay Intertech | CRCW04025K76FKED | LCSC | C2091613 | C2091613 | Extended | 1129 | $0.0100 | $0.01 | $0.0100 | $0.05 | Q 0.076 | Q 0.08 | Q 0.38 | Ever Ohms Tech CR0402F5K76Q10Z (LCSC C881162) | SIN_ALTERNO | POBLADO | ALTA |  | https://jlcpcb.com/partdetail/VishayIntertech-CRCW04025K76FKED/C2091613
B46 | Res | R13 | 1 | Resistencia 665 ohm 0.1% | 0402 | Vishay Intertech | TNPW0402665RBEED | LCSC | C2083064 | C2083064 | Extended | SIN_VERIFICAR_STOCK |  | $0.00 |  | $0.00 |  | Q 0.00 | Q 0.00 | Susumu RG1005V-6650-B-T5 (DigiKey RG1005V-6650-B-T5CT-ND) | TE Connectivity Passive Product RN73C1E665RBTG (DigiKey RN73C1E665RBTGCT-ND) | POBLADO | MEDIA | Precio y stock de C2083064 sin verificar (MEDIA). Exigir +-25 ppm/C: descartar KOA RN731ETTP6650B50 (50 ppm/C). Costo esperado: centavos a pocos centavos. | https://jlcpcb.com/partdetail/VishayIntertech-TNPW0402665RBEED/C2083064
B47 | Res | R44 | 1 | Resistencia 1.87 kohm 1% | 0603 | YAGEO | RT0603FRE071K87L | DigiKey | 13-RT0603FRE071K87LCT-ND |  | NoEnBiblioteca | 27026 | $0.0094 | $0.01 | $0.0094 | $0.05 | Q 0.072 | Q 0.07 | Q 0.36 | Vishay Dale CRCW06031K87FKEA (DigiKey 541-1.87KHCT-ND) | YAGEO RT0603WRC071K87L (LCSC C1720781) | POBLADO | ALTA | En DigiKey hay amplio stock inmediato: Yageo RT0603FRE071K87L (27,026 uds en stock, $0.00936/ud) y Vishay CRCW06031K87FKEA (27,519 uds en stock). En JLCPCB, Vishay CRCW06031K87FKEB (C4217238) tiene 0 stock hoy, pero existen las versiones de mayor precision Yageo RT0603WRC071K87L (C1720781, +-0.05% 15ppm) y Kamaya RMC1/16K1871DTP (C7343756, +-0.5%). | https://www.digikey.com/en/products/detail/yageo/RT0603FRE071K87L/1075184
B48 | Res | R4 | 1 | Resistencia 576 kohm 1% | 0603 | YAGEO | RC0603FR-07576KL | DigiKey | 311-576KHRCT-ND |  | NoEnBiblioteca | 10000 | $0.0100 | $0.01 | $0.0100 | $0.05 | Q 0.076 | Q 0.08 | Q 0.38 | ROHM Semiconductor MCR03ERTF5763 (DigiKey RHM576KHTR-ND) | KOA Speer Electronics, Inc. RN73R1JTTD5763F25 (DigiKey 2019-RN73R1JTTD5763F25CT-ND) | POBLADO | MEDIA | Confirmada disponibilidad inmediata en DigiKey (Buy now, ships today) en 3 fabricantes: Yageo RC0603FR-07576KL, ROHM MCR03ERTF5763 y KOA Speer RN73R1JTTD5763F25. Precio y stock exactos por confirmar en DigiKey. | https://www.digikey.com/en/products/detail/yageo/RC0603FR-07576KL/727311
B49 | Res | R27 RD1 RD2 RD3 RD4 RD5 RD7 RD9 | 8 | Resistencia 330 ohm (NO POBLAR: prefijo X_ en el simbolo) | 0402 | UNI-ROYAL (Uniroyal Elec) | 0402WGF3300TCE | LCSC | C25104 | C25104 | Basic | 2167998 | $0.0011 | $0.00 | $0.0011 | $0.00 | Q 0.008 | Q 0.00 | Q 0.00 |  |  | DNP | ALTA | X_ en simbolo (R27, RD1-RD5, RD7, RD9): no poblado (misma pieza que B32). | https://jlcpcb.com/partdetail/25847-0402WGF3300TCE/C25104
B50 | Res | R18 | 1 | Resistencia 5.1 kohm (NO POBLAR: prefijo X_ en el simbolo) | 0402 | UNI-ROYAL (Uniroyal Elec) | 0402WGF5101TCE | LCSC | C25905 | C25905 | Basic | 5060970 | $0.0023 | $0.00 | $0.0023 | $0.00 | Q 0.018 | Q 0.00 | Q 0.00 |  |  | DNP | ALTA | X_ en simbolo (R18): se asume NO poblado (misma pieza que B33). | https://jlcpcb.com/partdetail/0402WGF5101TCE/C25905

Sheet: Resumen
Resumen BOM - PI7C9X3G808GP PCIe Gen3 Switch | Kevin Flores | UNIS
Tipo de cambio GTQ por USD | 7.6419 | Referencia Banguat 2026-10-25 (Q7.6419); actualizar el dia de compra.
Concepto | 1 placa | 5 placas
Total USD (solo POBLADO con precio) | $88.29 | $432.41
Total GTQ | Q 674.73 | Q 3304.47
USD adicional si se poblaran los DNP (precio disponible) | $0.40 | $1.98
Lineas poblado / DNP / opcional-pendiente | 56 / 3 / 3
Excluido del total: A13B (standoff opcional), A14 (P1, MPN por confirmar), A18 (test points sin pieza), B36/B42/B46 (precio sin verificar), P2 (dedos PCIe, es cobre del PCB) e ID-BOARD (marca mecanica, no es pieza).
Precios unitarios segun cantidad de cada escenario (1 y 5 placas); IVA, envio y aranceles no incluidos. Fecha de consulta: 2026-11-08.

Sheet: Notas
Notas y riesgos
- A01 PI7C9X3G808GP: EOL anunciado por Diodes (PCN-2740). CHFCEX activo hoy, lead time 39 semanas, ~$53.70, sin alterno. Comprar primero.
- A06: se cambio a Nexperia 74LVC07APW,118 (4,543 en stock) porque SN74LVC07APWR tenia 0 en stock.
- A08 / Q1: pinout G-S-D verificado contra el footprint SOT23SGD_T (equivale a SOT-23 estandar girado 180 grados). Confirmar visualmente que Q1 este en TOP.
- A13 M.2: usar 1-2199230-4 (Key M). 2199230-4 es Key E. Altura 4.2 mm.
- A13B: standoff opcional; el footprint tiene agujero PTH 3.2 mm, no pad SMD.
- A14 / P1: 4 pads a 5.08 mm, 12V-GND-GND-5V. Candidato Molex 15-24-4441, sin precio ni PN verificado.
- B36: 25.0 k no es E96; se usa 24.9 k 1%. Alterno exacto Vishay 0.1% a $3.37.
- B42 y B46: existen en LCSC pero precio y stock no se verificaron.
- DNP (X_ en simbolo): B22, B49, B50. Se asumen sin poblar; fuera de los totales.
- Capacitores: B04 (22 uF 25 V) y B22 (100 uF 6.3 V) pierden capacidad por DC bias; considerar derating en el informe.
- Fuentes: DigiKey, Mouser, LCSC/JLCPCB, TE, Diodes (consulta 2026-11-08).
