ksflores-cmyk/PCIe808_SW/symbols/step/RZR0016A.stp

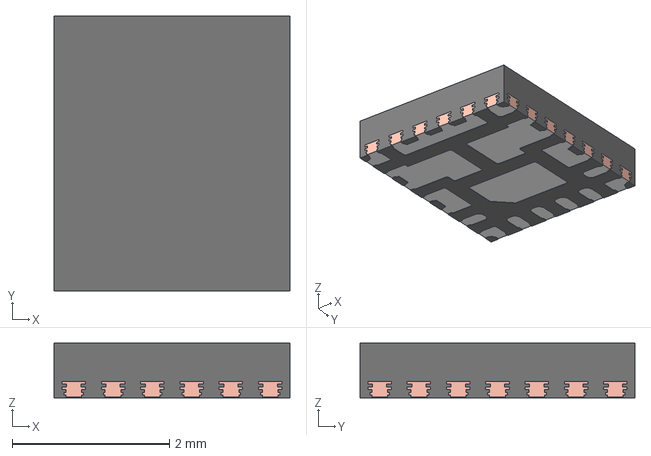
[picture p18: CAD file, 2026-10-25]
symbols/step/RZR0016A.stp
3.00 x 3.50 x 0.7 mm
RZR0016A_FRAME
RZR0016A_MOLD
