ksflores-cmyk/PCIe808_SW/symbols/step/RPG0014A.stp

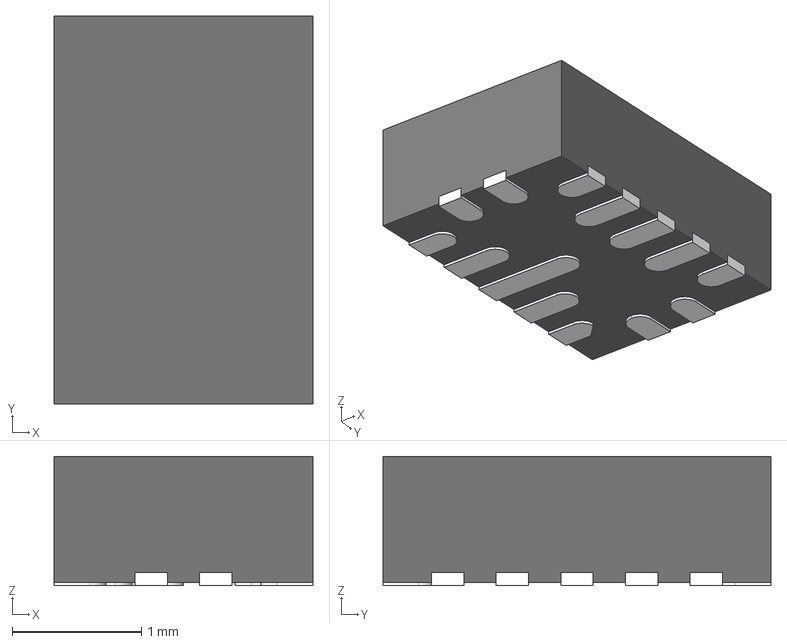
[picture p19: CAD file, 2026-10-25]
symbols/step/RPG0014A.stp
2.00 x 3.00 x 1.00 mm
FRAME
