ksflores-cmyk/PCIe808_SW/symbols/step/DRL0008A.stp

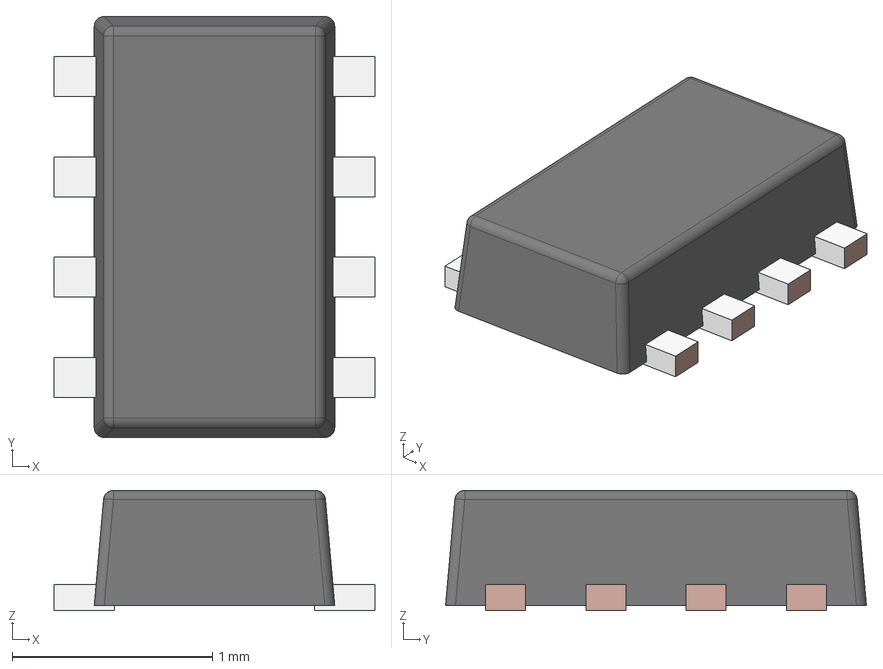
[picture p20: CAD file, 2026-10-25]
symbols/step/DRL0008A.stp
1.60 x 2.10 x 0.6 mm
FRAME-DRL0008A
BODY-SOT
