ksflores-cmyk/PCIe808_SW/(list of files, cad)

Other CAD files:
symbols/455580003.psm
symbols/blkcon100vhtm2oew20032.psm
symbols/c0402.psm
symbols/c0402_bga.psm
symbols/c0603.psm
symbols/c0805.psm
symbols/c1206.psm
symbols/c1210.psm
symbols/dfn8-0303-_65.psm
symbols/head1x3_2_54mm.psm
symbols/hfcbga_196_15x15.psm
symbols/ind_xal5020.psm
symbols/ind_xal7030.psm
symbols/ind_xal8080.psm
symbols/l1812.psm
symbols/led-0805.psm
symbols/m2_m_2280_kf.psm
symbols/pci-exp-16x.psm
symbols/pci_exp_slot_x4.psm
symbols/pci_express_x4.psm
symbols/pwr-4p-90.psm
symbols/r0402.psm
symbols/r0603.psm
symbols/rpg0014a-mfg.psm
symbols/rzr0016a-mfg.psm
symbols/soic8_1r27_kf.psm
symbols/sot23_5_kf.psm
symbols/sot23sgd_t.psm
symbols/sot5x3-8_drl_tex.psm
symbols/testpin25.psm
symbols/ti_drl0008a_kf.psm
symbols/ti_rpg0014a_kf.psm
symbols/ti_rzr0016a_kf.psm
symbols/tssop14_0r65_kf.psm
symbols/vssop8_0r5_kf.psm
