ksflores-cmyk/PCIe808_SW/outputs/PI7_KEVINFLORES_esquematico.pdf

# PCIe PI7C9X3G808GP

# UNIVERSIDAD DEL ISTMO DE GUATEMALA

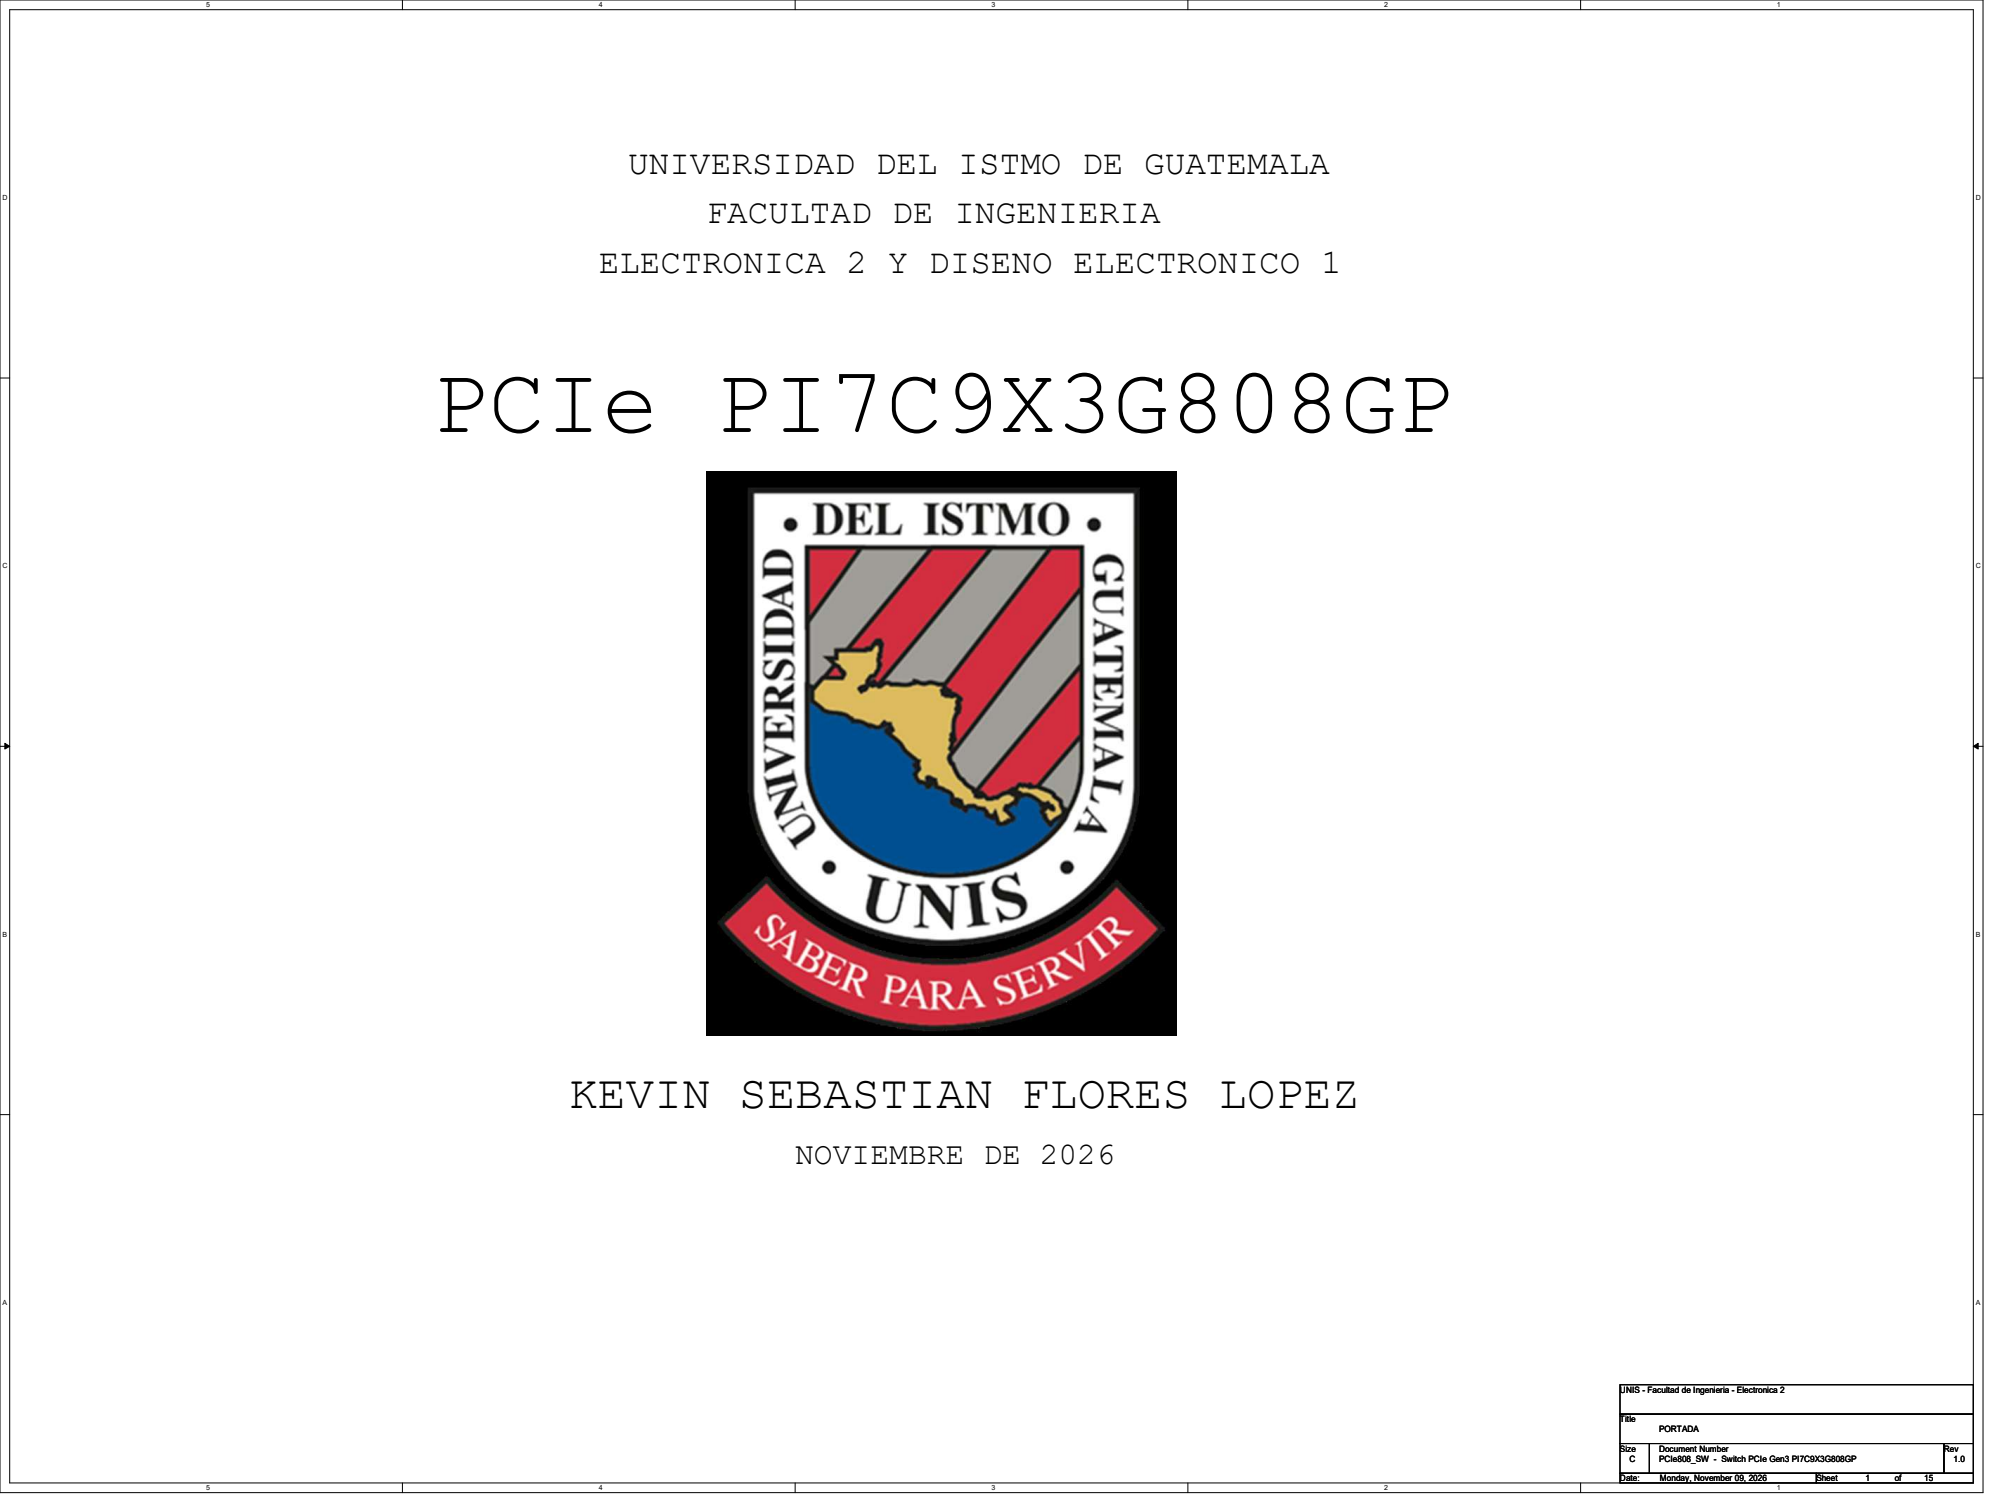
[picture p21: page 1]
NOVIEMBRE DE 2026; Title Size; Document Number; Rev Date:; Sheet; of PCIe808_SW - Switch PCIe Gen3 PI7C9X3G808GP; 1.0 PORTADA UNIS - Facultad de Ingenieria - Electronica 2 C; Monday, November 09, 2026; 15 Title Size

FACULTAD DE INGENIERIA
ELECTRONICA 2 Y DISENO ELECTRONICO 1

KEVIN SEBASTIAN FLORES LOPEZ

# INDICE DE HOJAS

Pag.

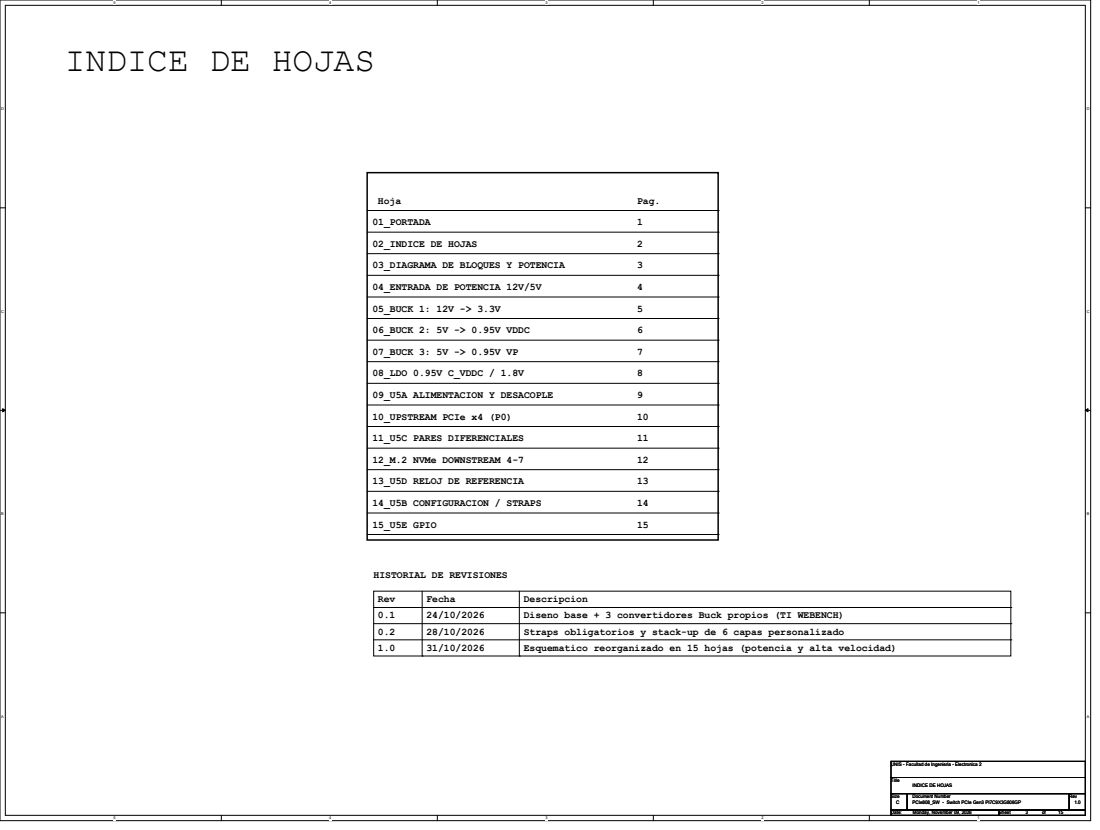
[picture p22: page 2]
Rev; Fecha; Descripcion; Diseno base + 3 convertidores Buck propios (TI WEBENCH); Straps obligatorios y stack-up de 6 capas personalizado; Esquematico reorganizado en 15 hojas (potencia y alta velocidad); 06_BUCK 2: 5V -> 0.95V VDDC; 11_U5C PARES DIFERENCIALES; 12_M.2 NVMe DOWNSTREAM 4-7; 04_ENTRADA DE POTENCIA 12V/5V; 02_INDICE DE HOJAS; 14_U5B CONFIGURACION / STRAPS; 03_DIAGRAMA DE BLOQUES Y POTENCIA; 13_U5D RELOJ DE REFERENCIA; 05_BUCK 1: 12V -> 3.3V; 01_PORTADA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

HISTORIAL DE REVISIONES

# DIAGRAMA DE BLOQUES Y ARBOL DE POTENCIA

# DIAGRAMA DE BLOQUES (SENALES)

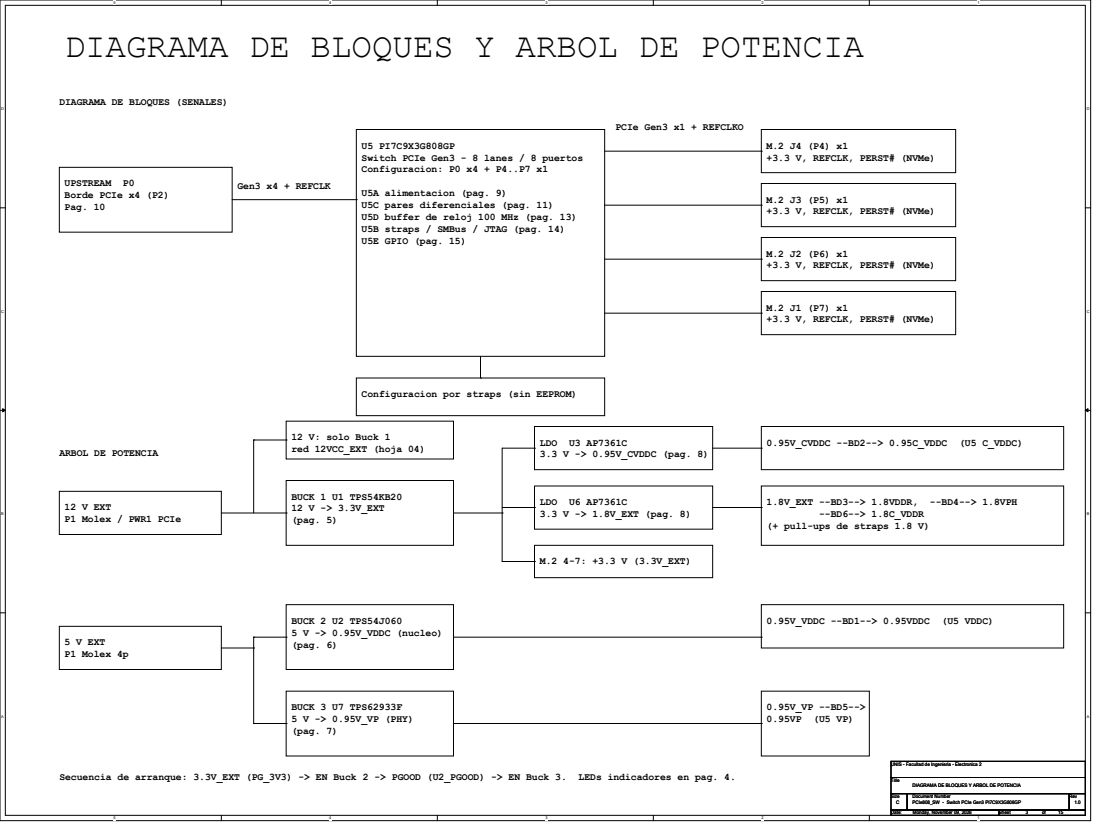
[picture p23: page 3]

U5A alimentacion (pag. 9)
U5C pares diferenciales (pag. 11)
U5D buffer de reloj 100 MHz (pag. 13)
U5B straps / SMBus / JTAG (pag. 14)
U5E GPIO (pag. 15)

Configuracion por straps (sin EEPROM)

(+ pull-ups de straps 1.8 V)

Secuencia de arranque: 3.3V_EXT (PG_3V3) -> EN Buck 2 -> PGOOD (U2_PGOOD) -> EN Buck 3. LEDs indicadores en pag. 4.

# ENTRADA DE POTENCIA 12 V / 5 V

Entrada de 12 V y 5 V externos (P1 Molex 4p / PWR1 PCIe 6p), desacople bulk, alimentacion de los Buck e indicadores LED.

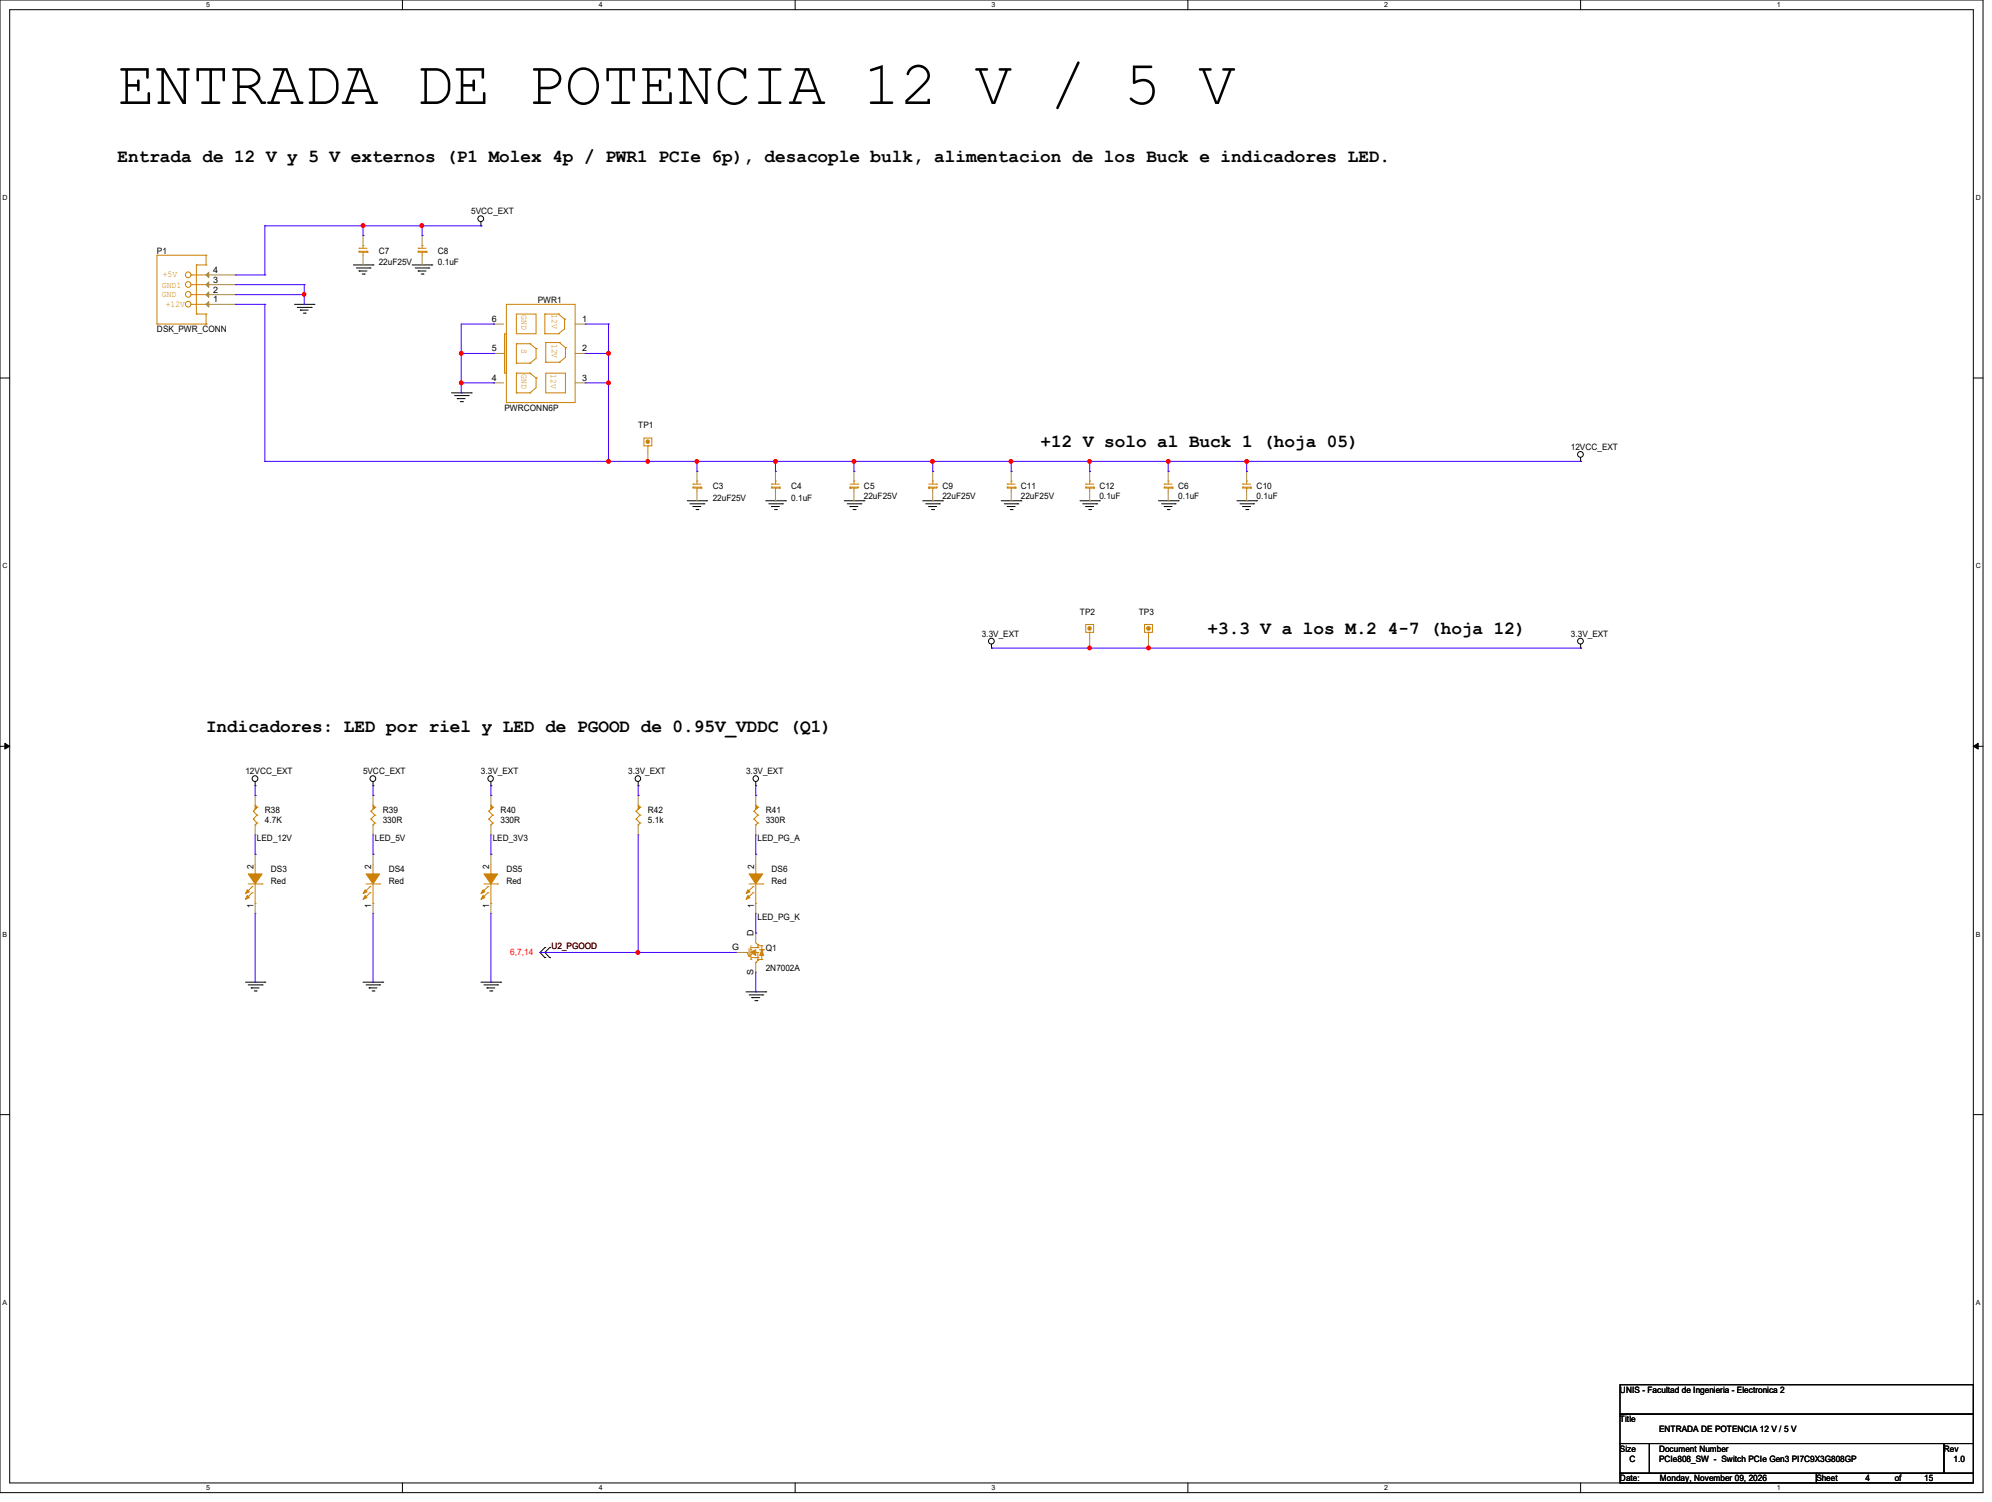
[picture p24: page 4]

+12 V solo al Buck 1 (hoja 05)

Indicadores: LED por riel y LED de PGOOD de 0.95V_VDDC (Q1)

# BUCK 1: 12 V -> 3.3 V

U1 TPS54KB20: 12 V -> 3.3V_EXT. Alimenta los 4 M.2 NVMe (hasta ~2.5 A c/u) y los LDO U3/U6. Su PG (PG_3V3) habilita el Buck 2.

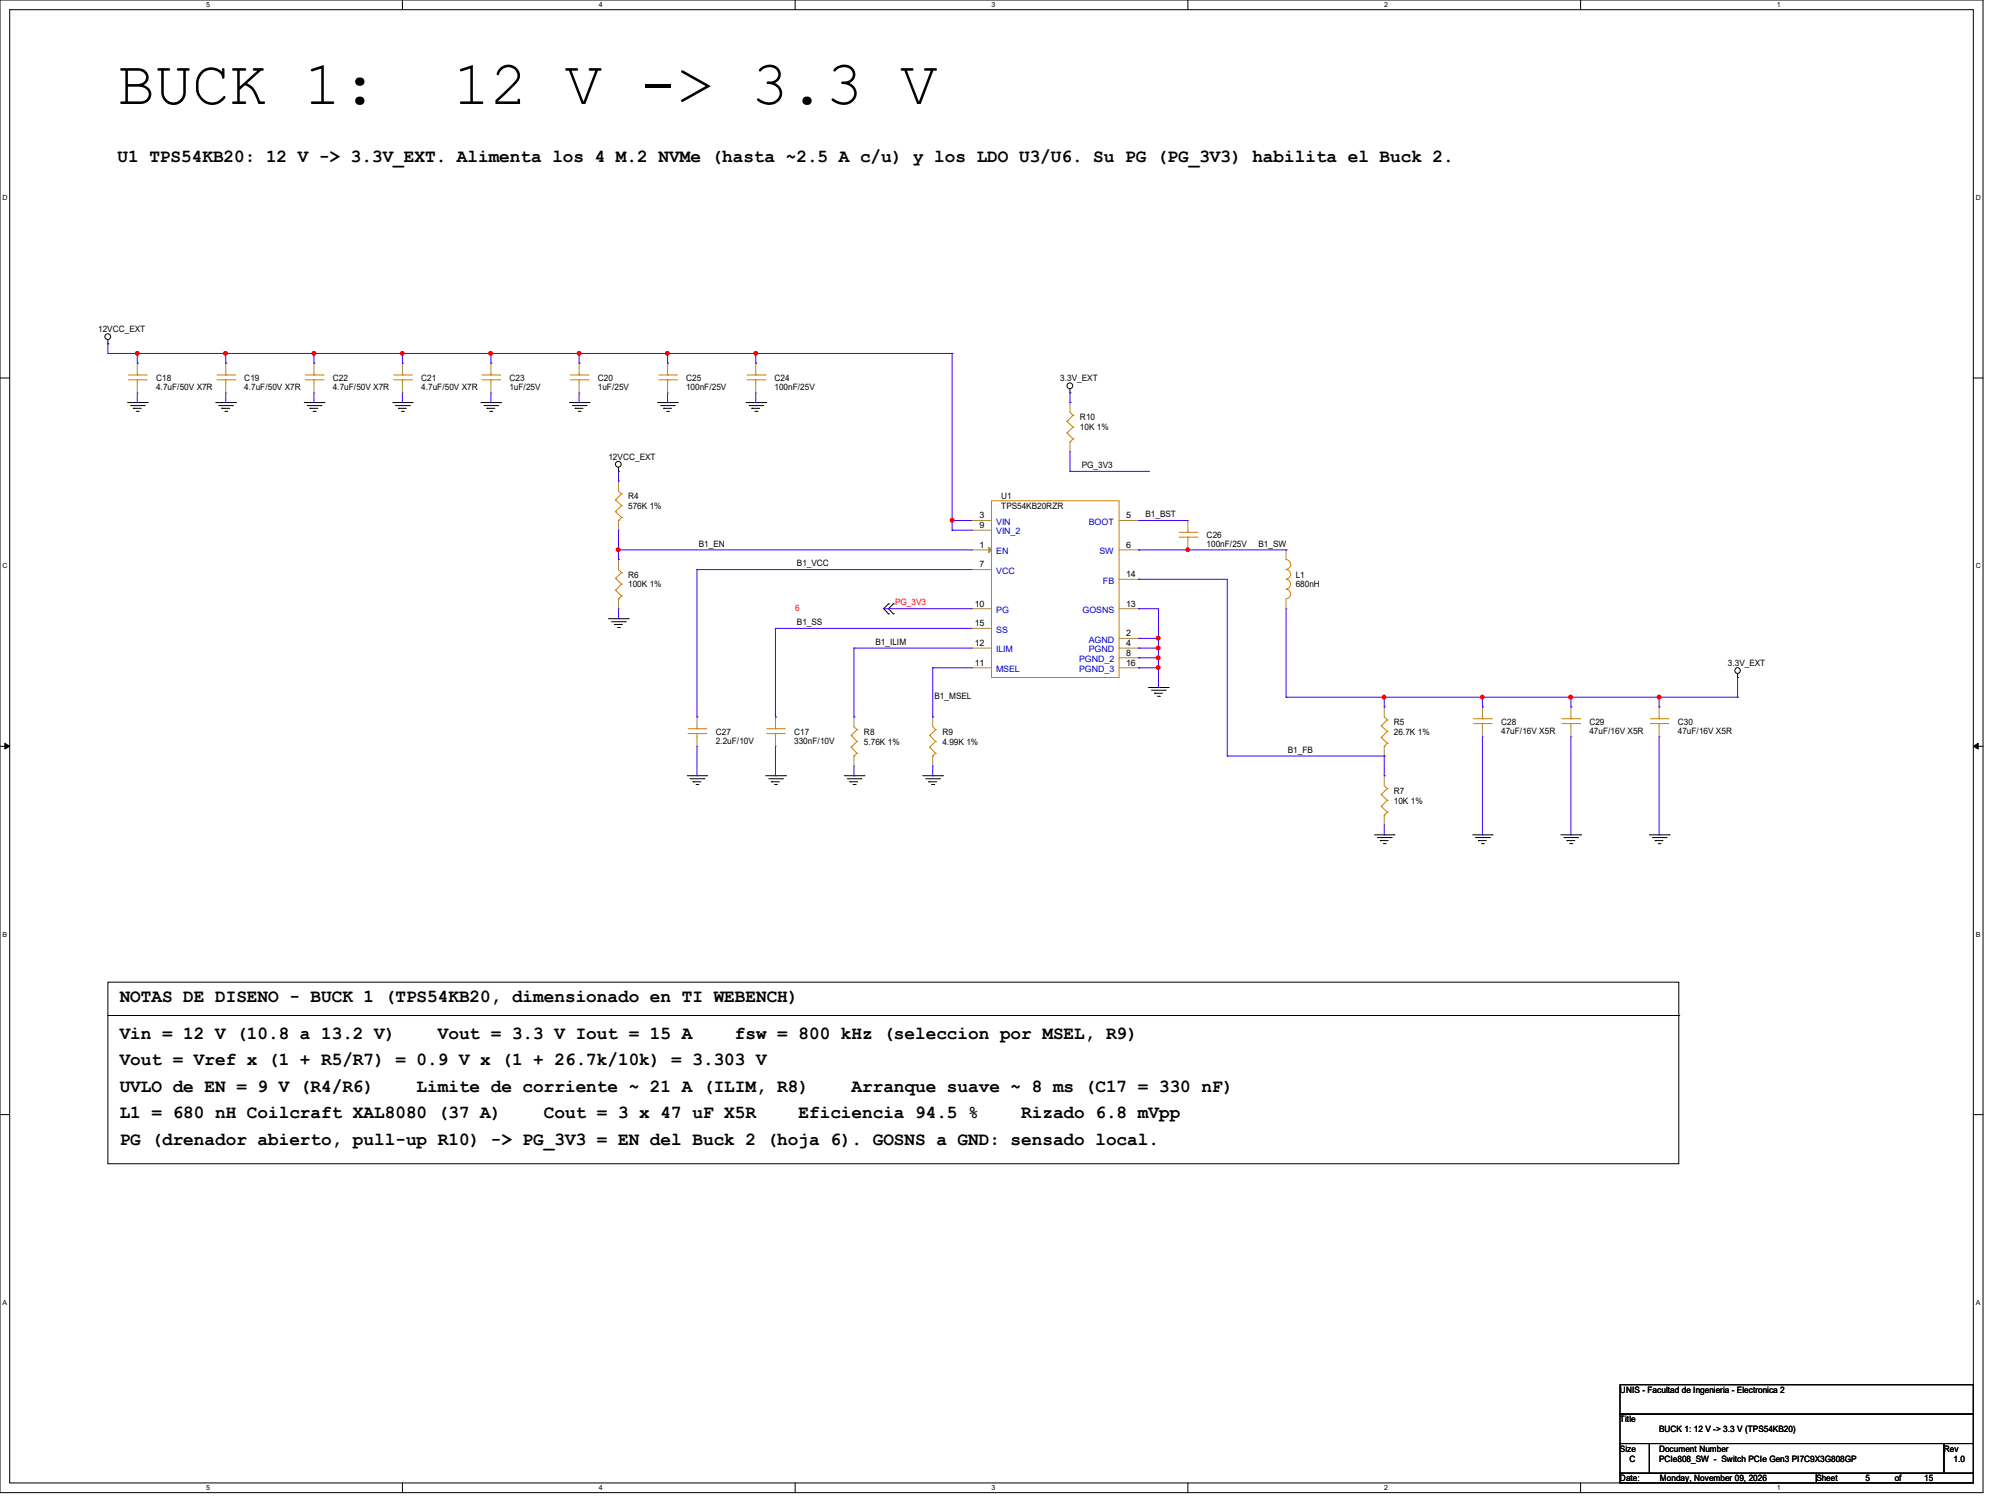
[picture p25: page 5]

NOTAS DE DISENO - BUCK 1 (TPS54KB20, dimensionado en TI WEBENCH)
Vout = Vref x (1 + R5/R7) = 0.9 V x (1 + 26.7k/10k) = 3.303 V
PG (drenador abierto, pull-up R10) -> PG_3V3 = EN del Buck 2 (hoja 6). GOSNS a GND: sensado local.

# BUCK 2: 5 V -> 0.95 V VDDC

U2 TPS54J060: 5 V -> 0.95V_VDDC (nucleo del switch). EN = PG_3V3. Su PGOOD (U2_PGOOD) habilita el Buck 3 y enciende DS6.

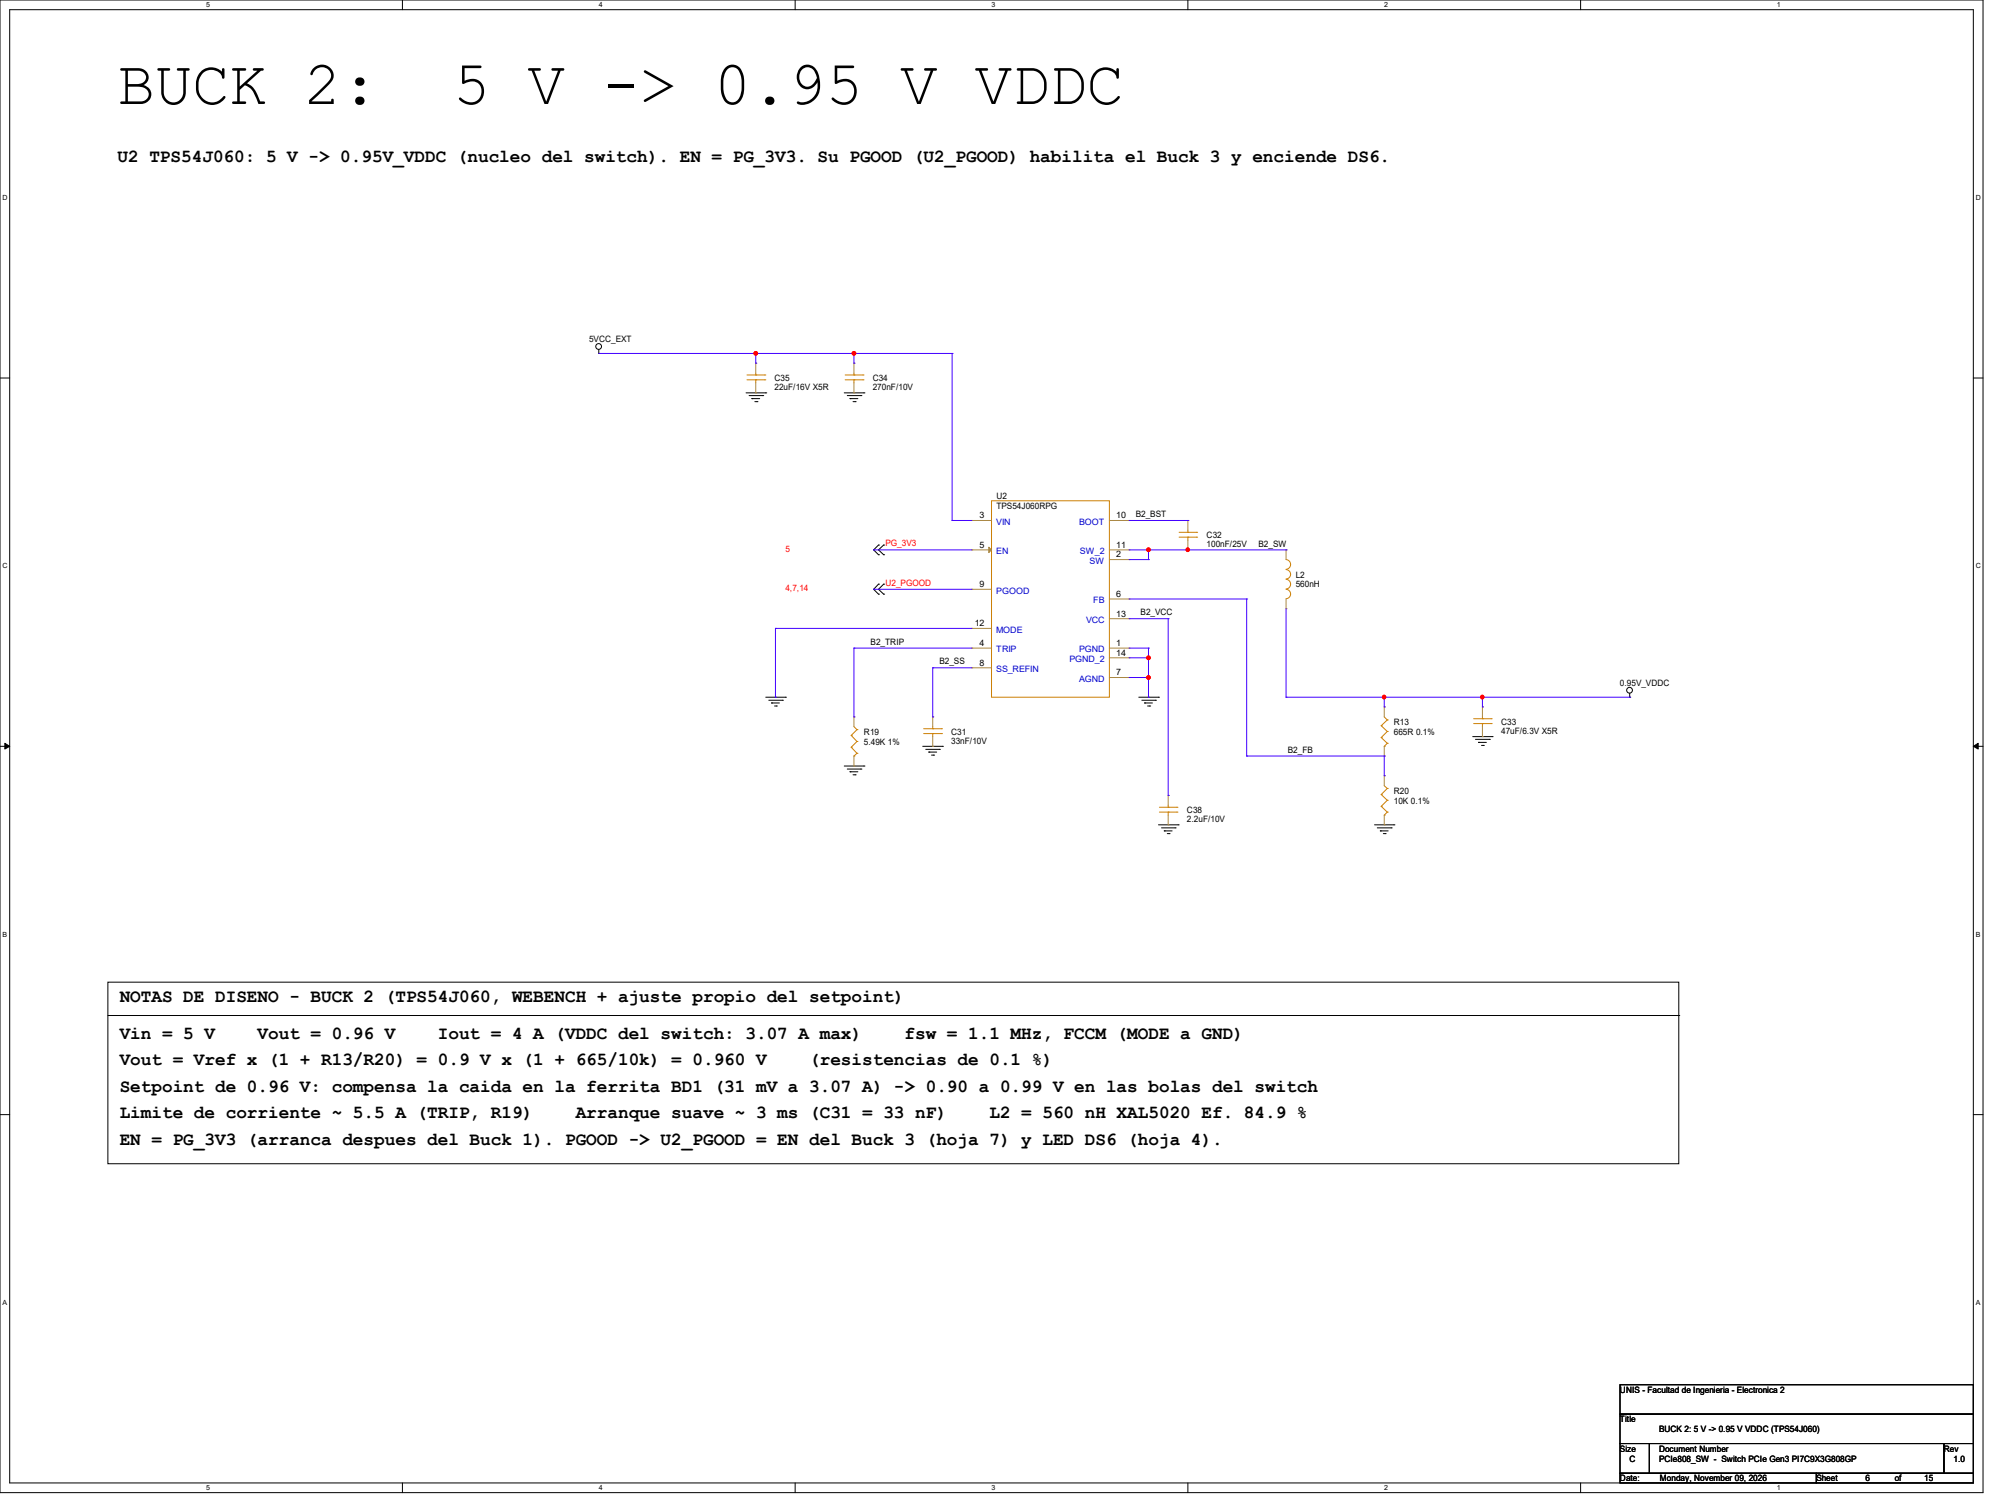
[picture p26: page 6]

NOTAS DE DISENO - BUCK 2 (TPS54J060, WEBENCH + ajuste propio del setpoint)
Setpoint de 0.96 V: compensa la caida en la ferrita BD1 (31 mV a 3.07 A) -> 0.90 a 0.99 V en las bolas del switch
EN = PG_3V3 (arranca despues del Buck 1). PGOOD -> U2_PGOOD = EN del Buck 3 (hoja 7) y LED DS6 (hoja 4).

# BUCK 3: 5 V -> 0.95 V VP

U7 TPS62933F: 5 V -> 0.95V_VP (PHY del switch). EN = U2_PGOOD. Vout = 0.8 V x (1 + R44/R43) = 0.95 V.

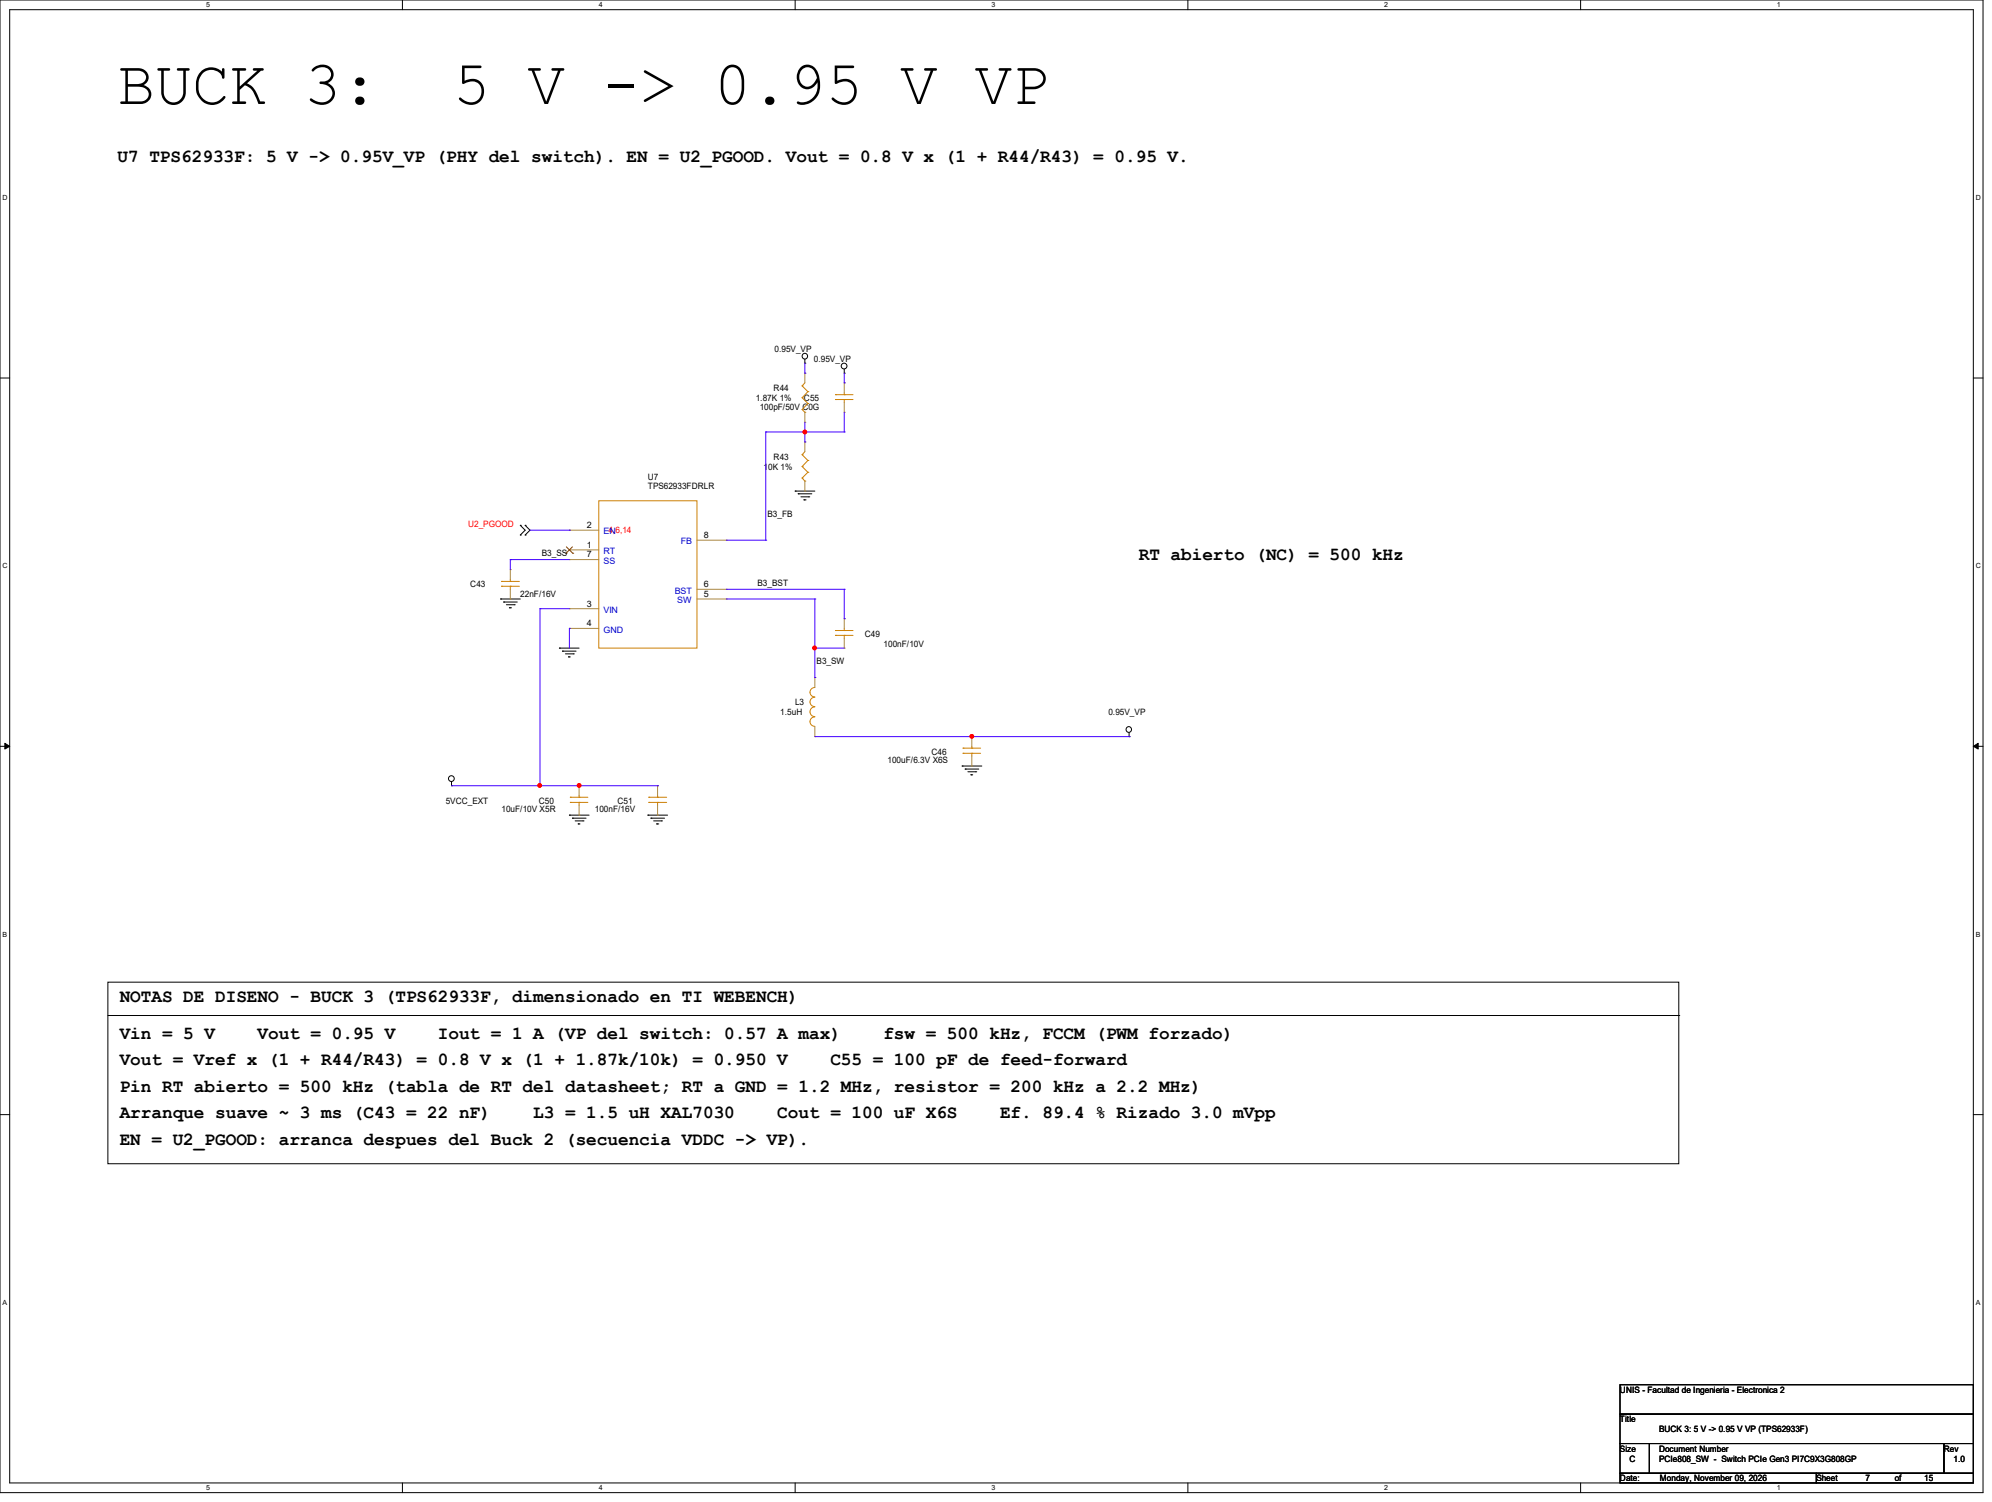
[picture p27: page 7]

RT abierto (NC) = 500 kHz

NOTAS DE DISENO - BUCK 3 (TPS62933F, dimensionado en TI WEBENCH)
Pin RT abierto = 500 kHz (tabla de RT del datasheet; RT a GND = 1.2 MHz, resistor = 200 kHz a 2.2 MHz)
EN = U2_PGOOD: arranca despues del Buck 2 (secuencia VDDC -> VP).

## R1Vout=0.8V{(R1+R2)/R2}

0.95V / 1A

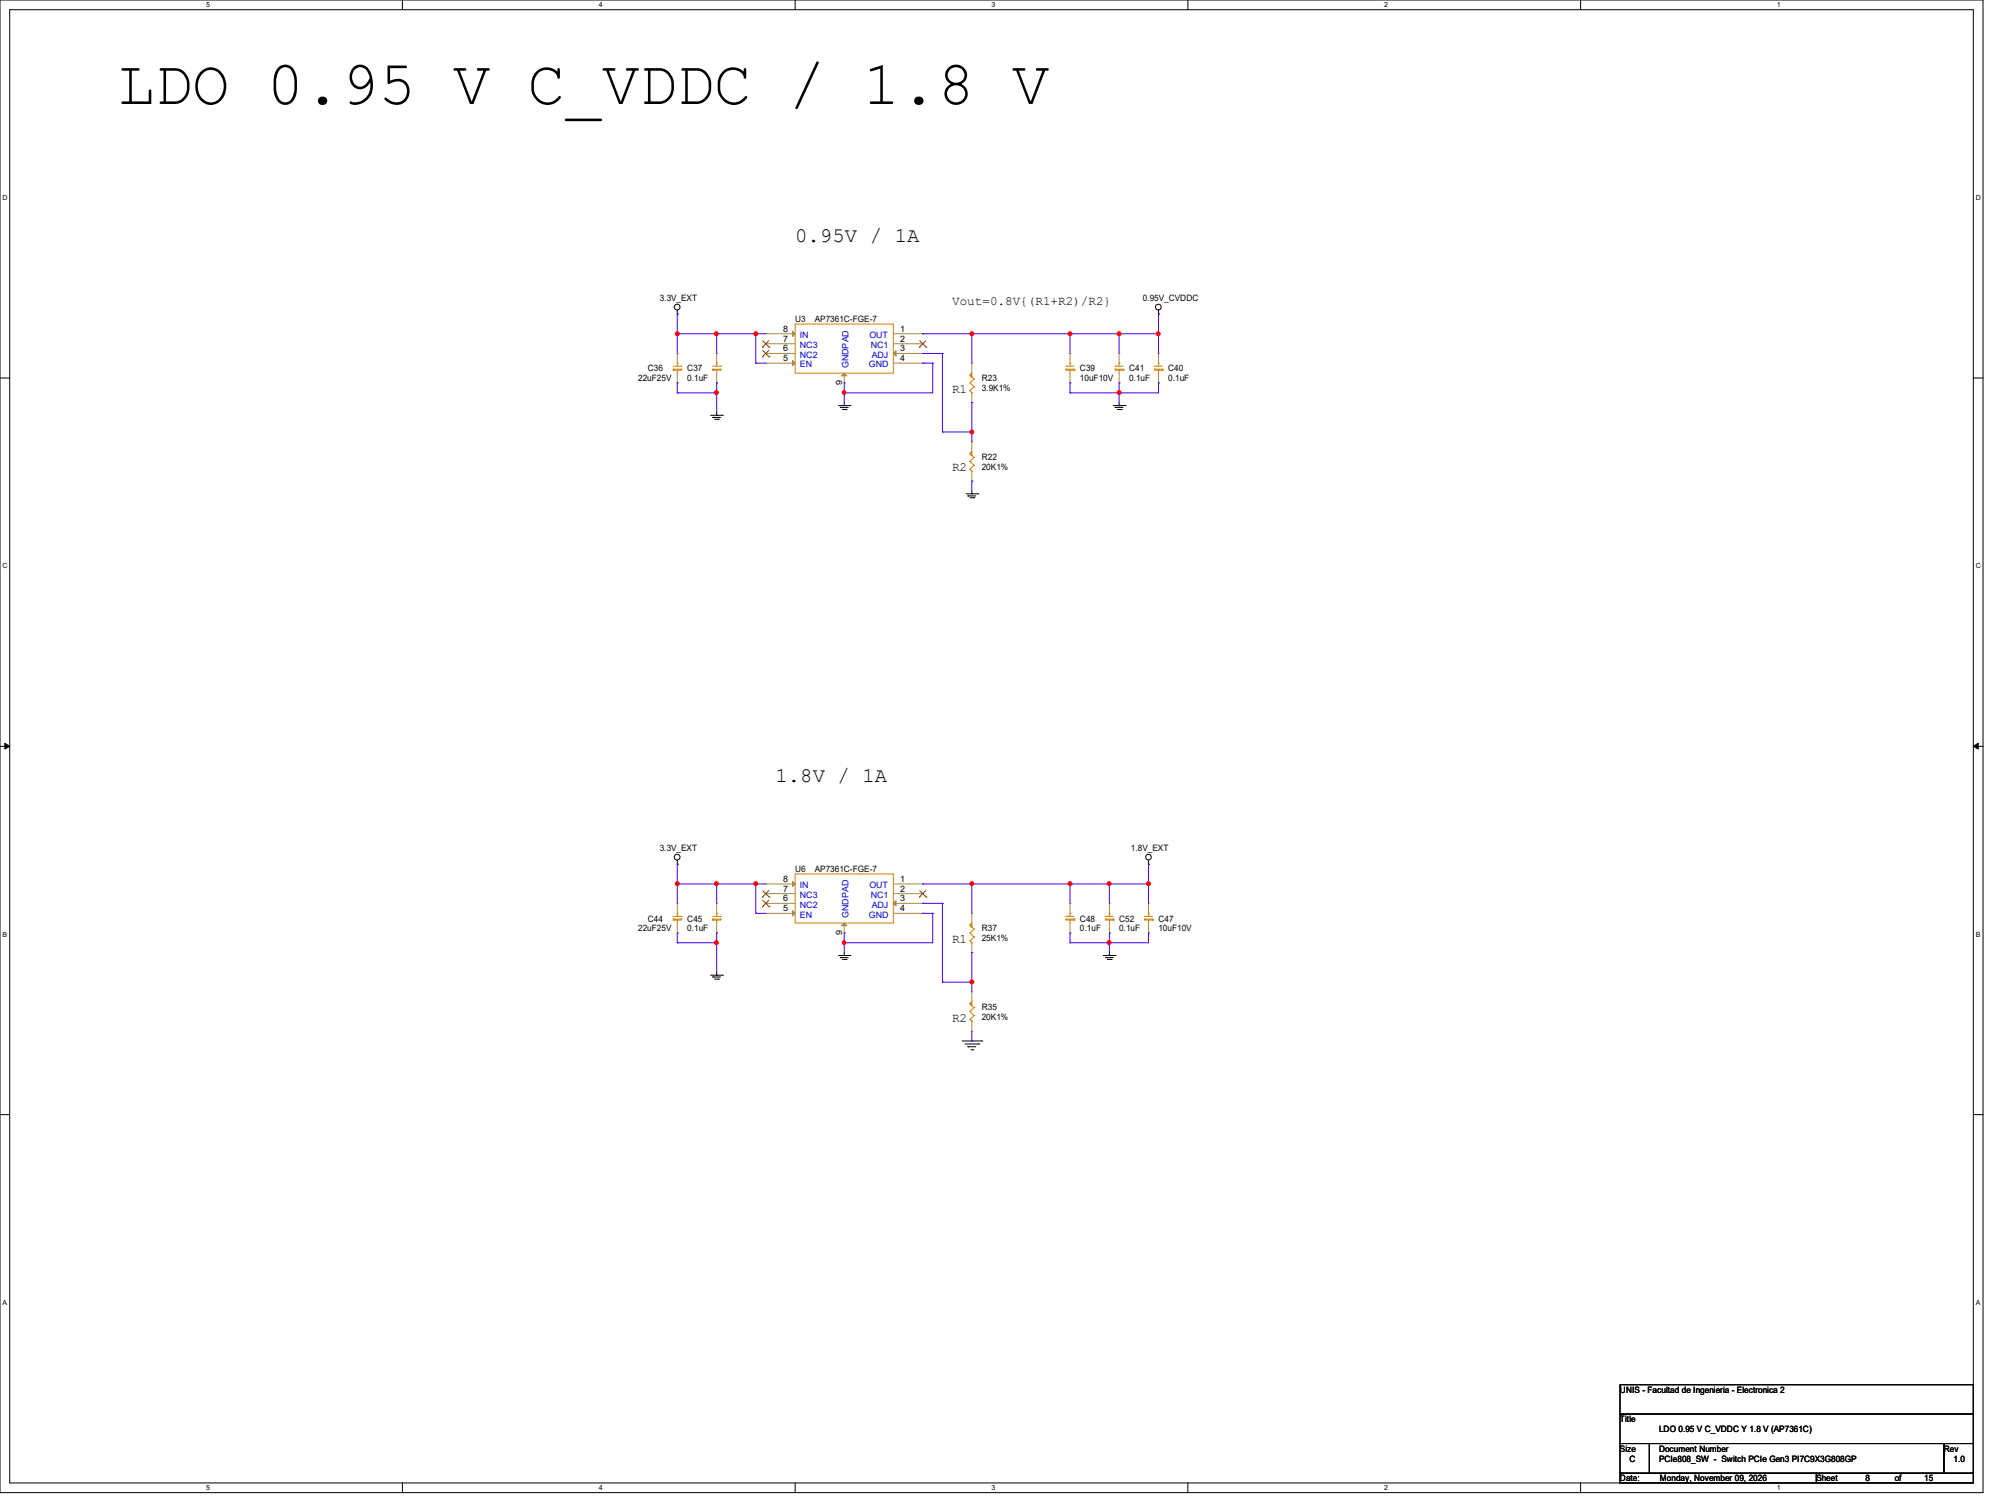
[picture p28: page 8]

# U5A - ALIMENTACION Y DESACOPLE

# 0.1uF C81

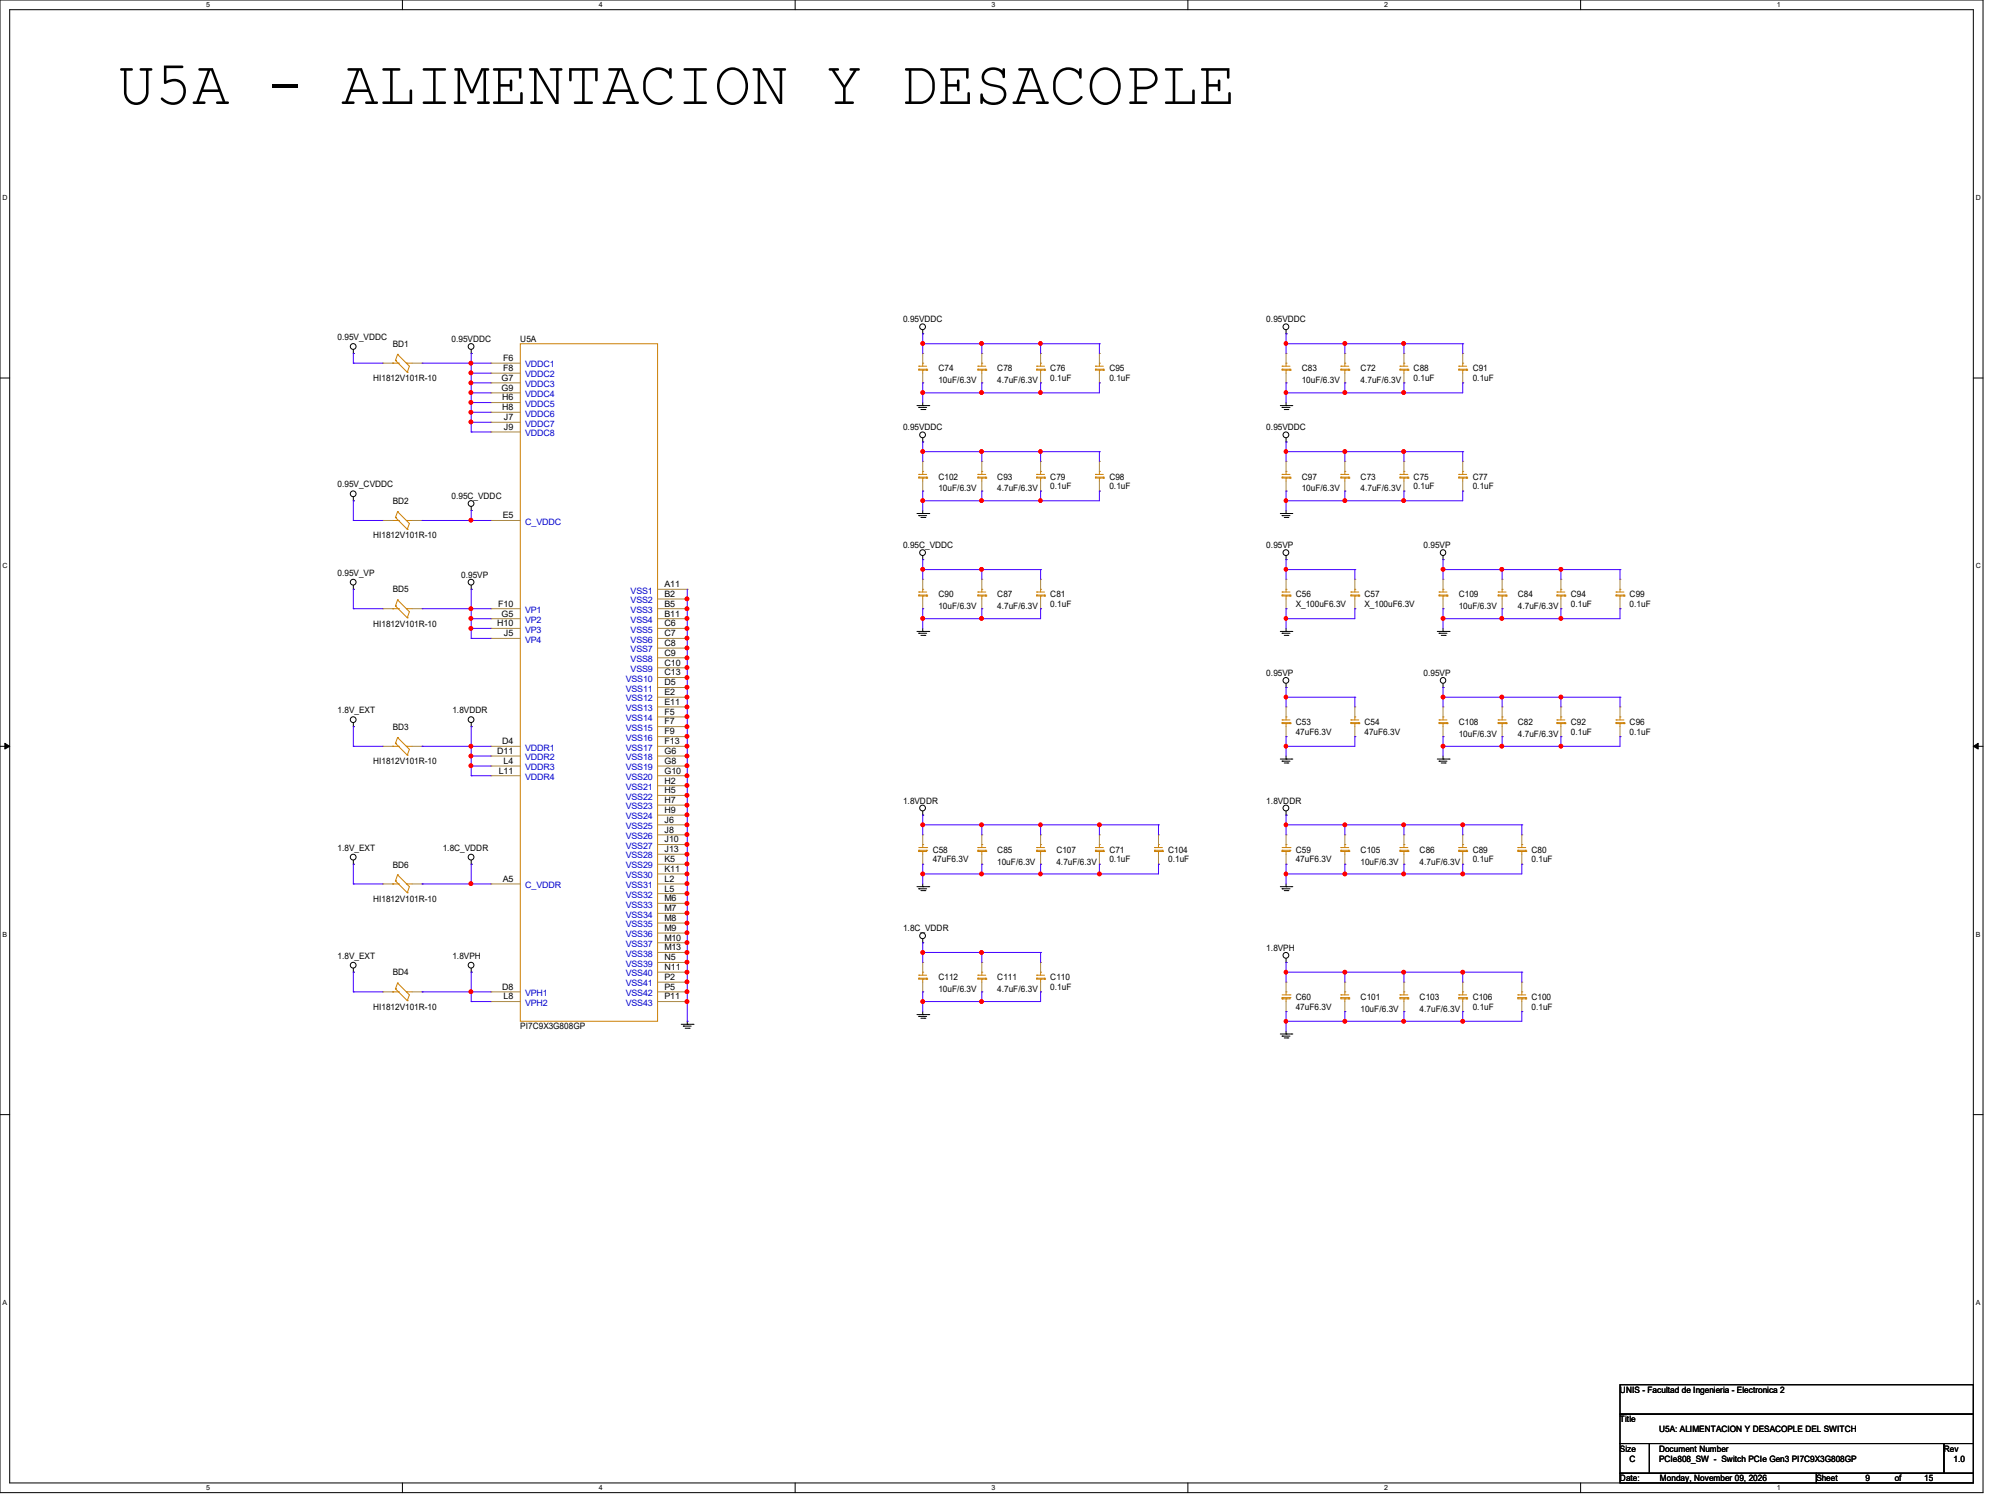
[picture p29: page 9]

# UPSTREAM PCIe x4 (PUERTO 0)

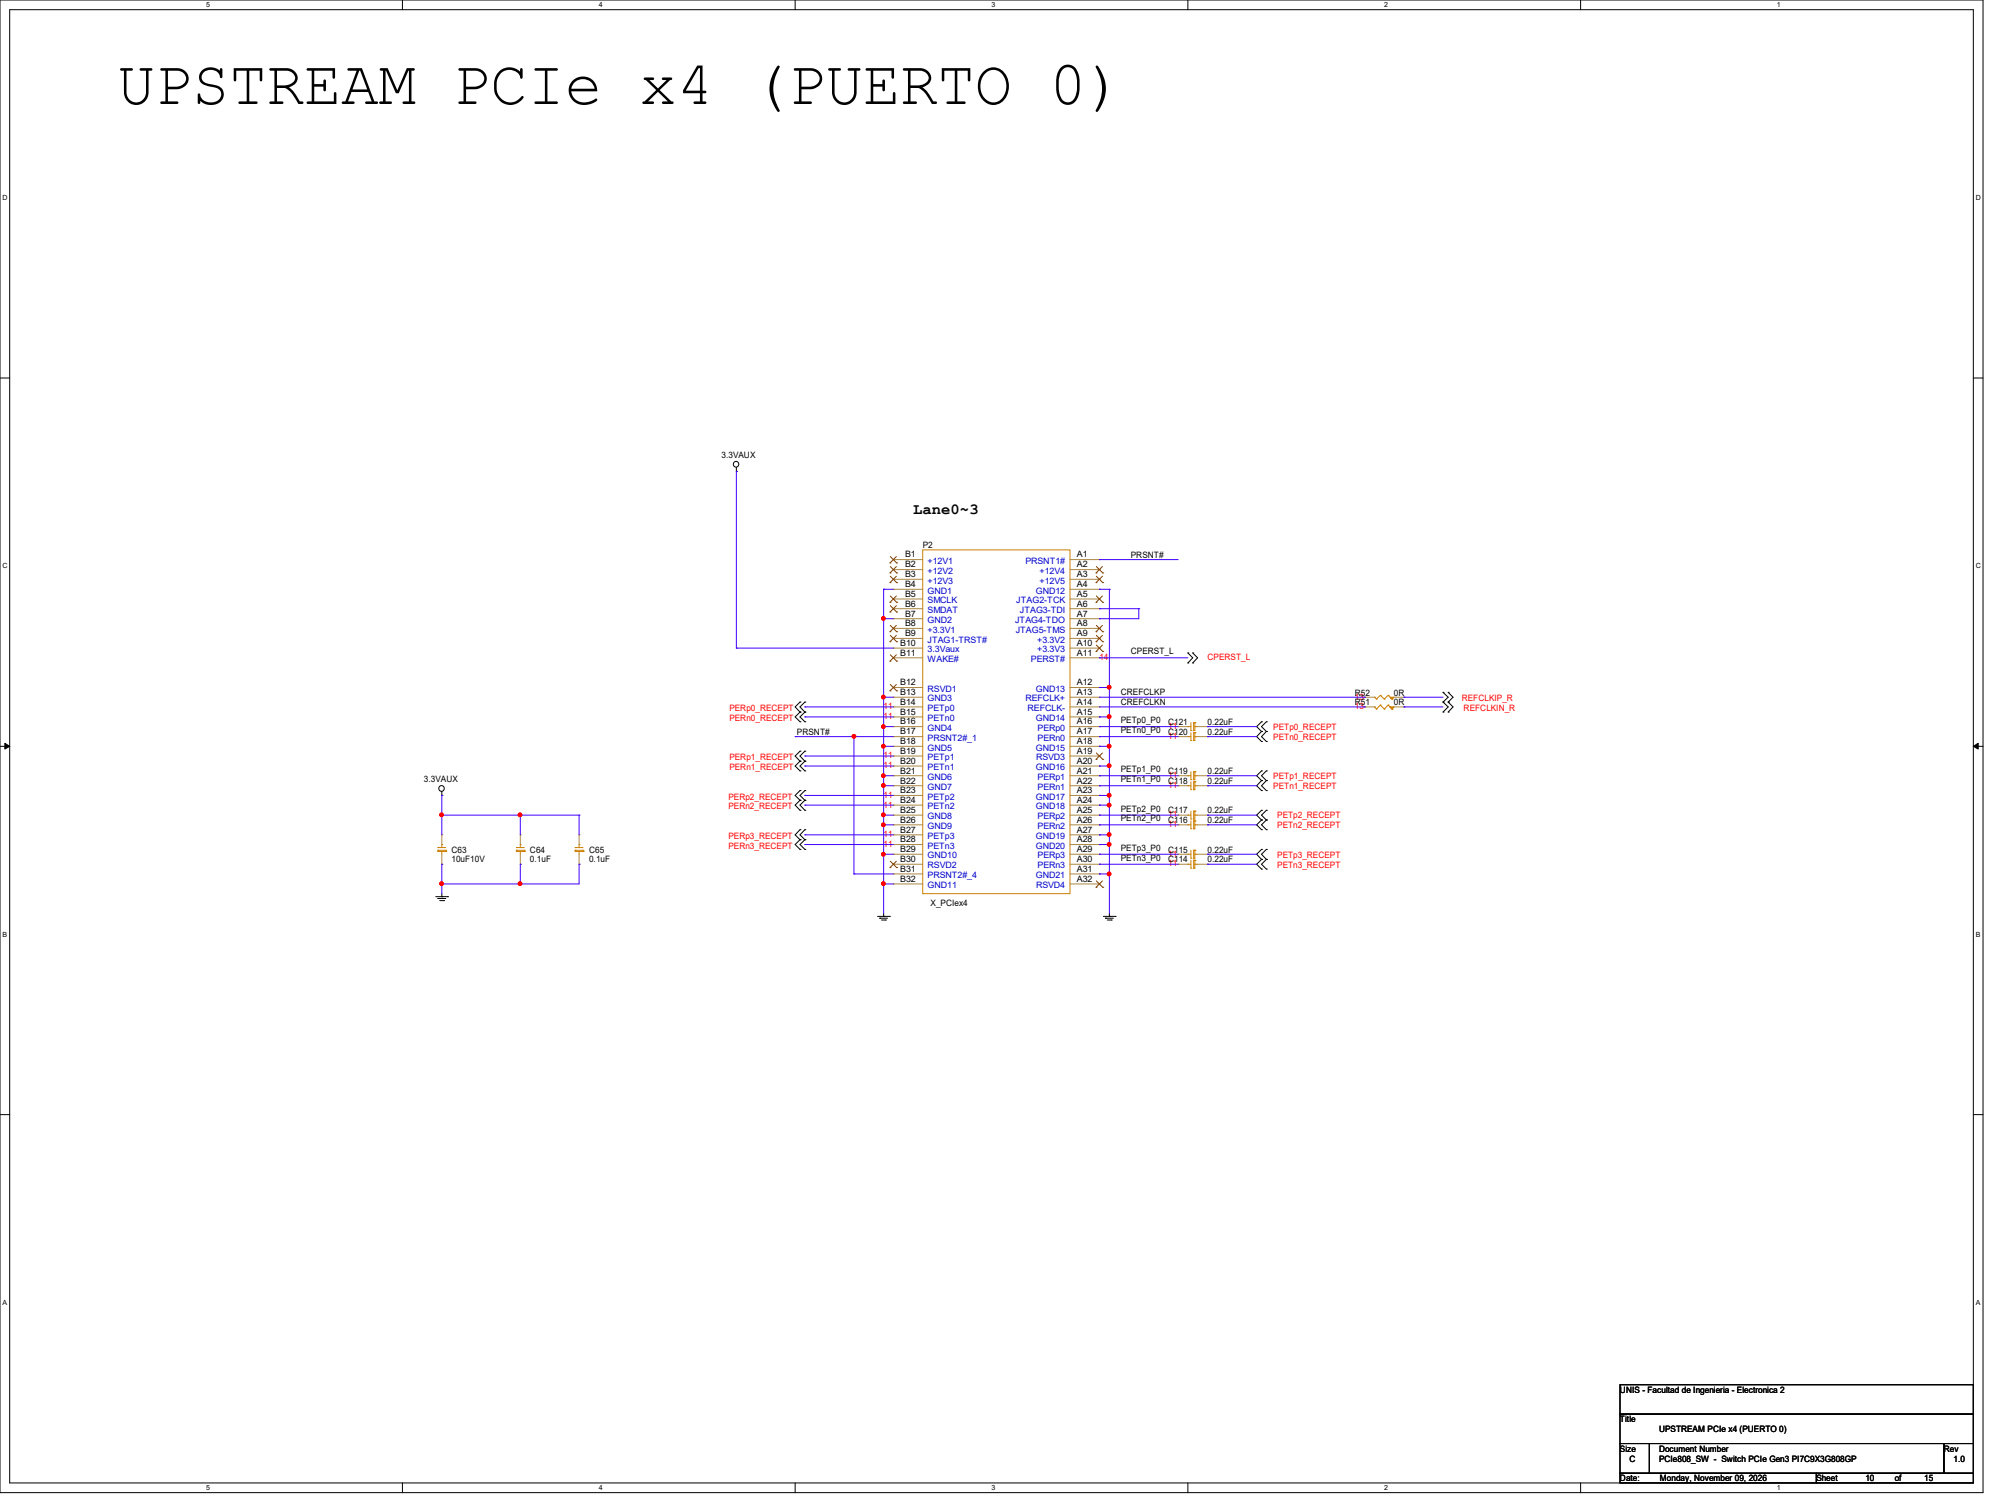
[picture p30: page 10]

# U5C - PARES DIFERENCIALES

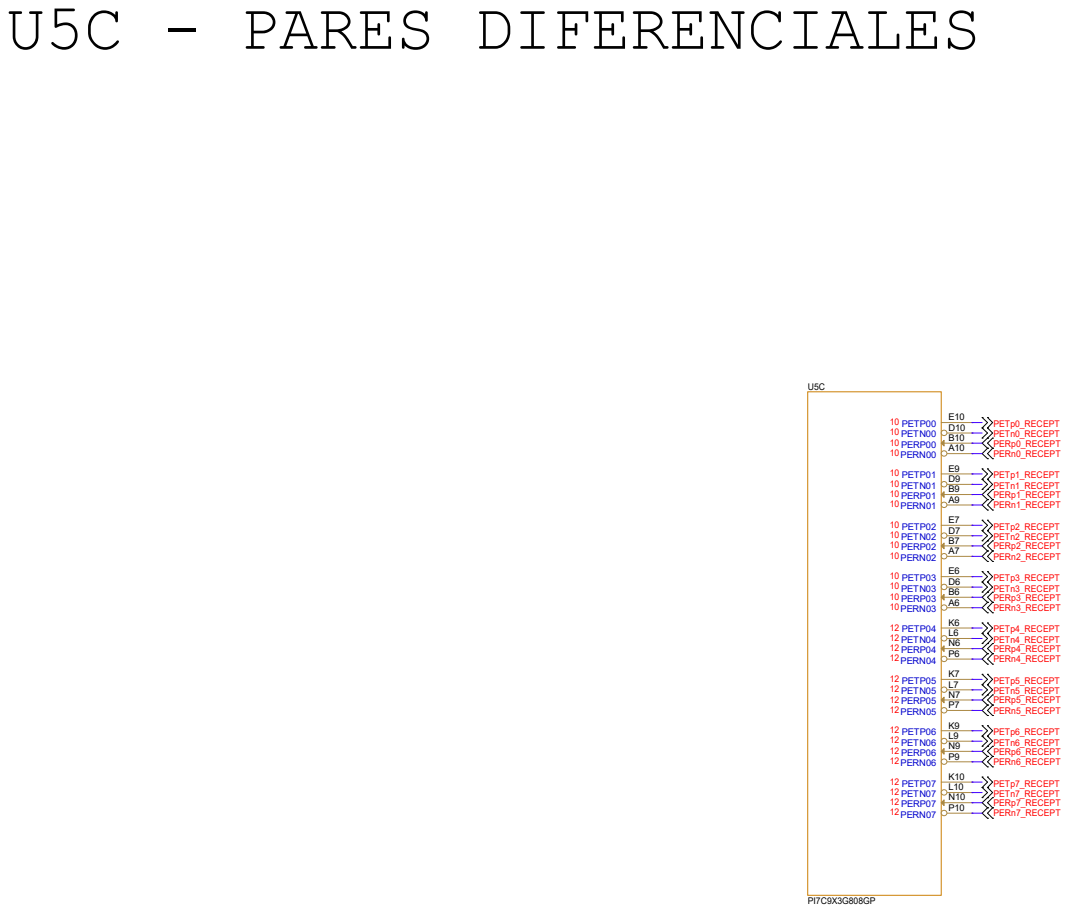
[picture p31: page 11]

# M.2 NVMe - PUERTOS DOWNSTREAM 4 a 7

PERp0 43 | PERn0 41 | PETp0 49 | PETn0 47 | REFCLKp 55 | REFCLKn 53 | PERST# 50 | CLKREQ# 52 | PEWAKE# 54 | PEDET 69 | SUSCLK 68 | DAS/DSS# 10 | SMB_CLK 40 | SMB_DATA 42 | ALERT# 44 | DEVSLP 38 | PERp1 31 | PERn1 29 | PETp1 37 | PETn1 35 | PERp2 19 | PERn2 17 | PETp2 25 | PETn2 23 | PERp3 7 | PERn3 5 | PETp3 13 | PETn3 11

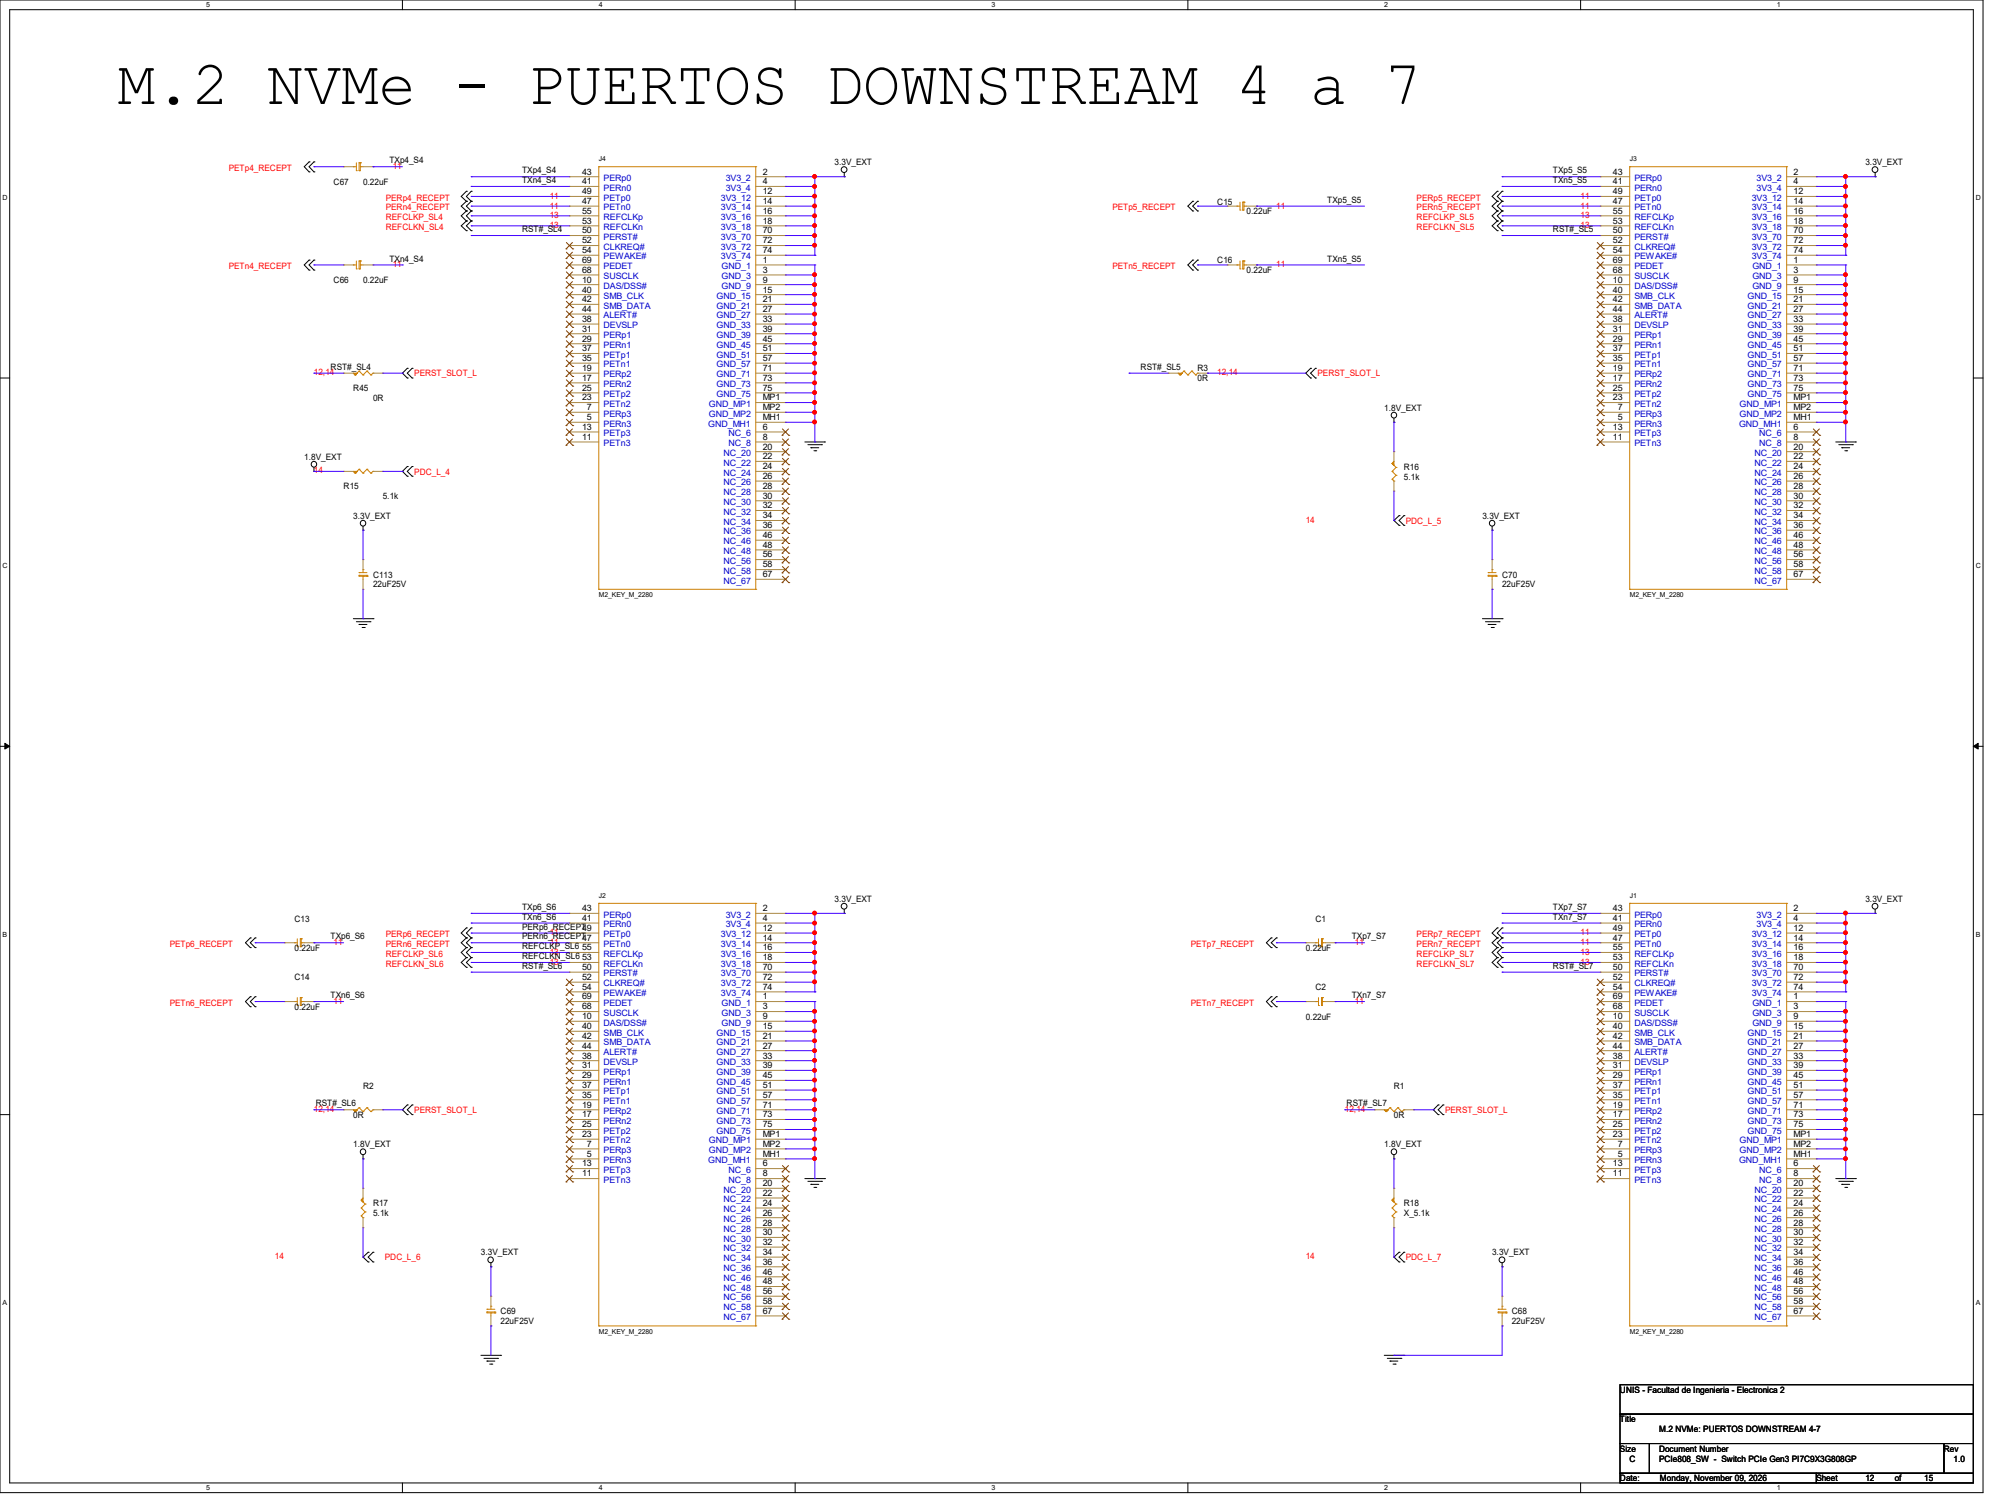
[picture p32: page 12]

# U5D - RELOJ DE REFERENCIA

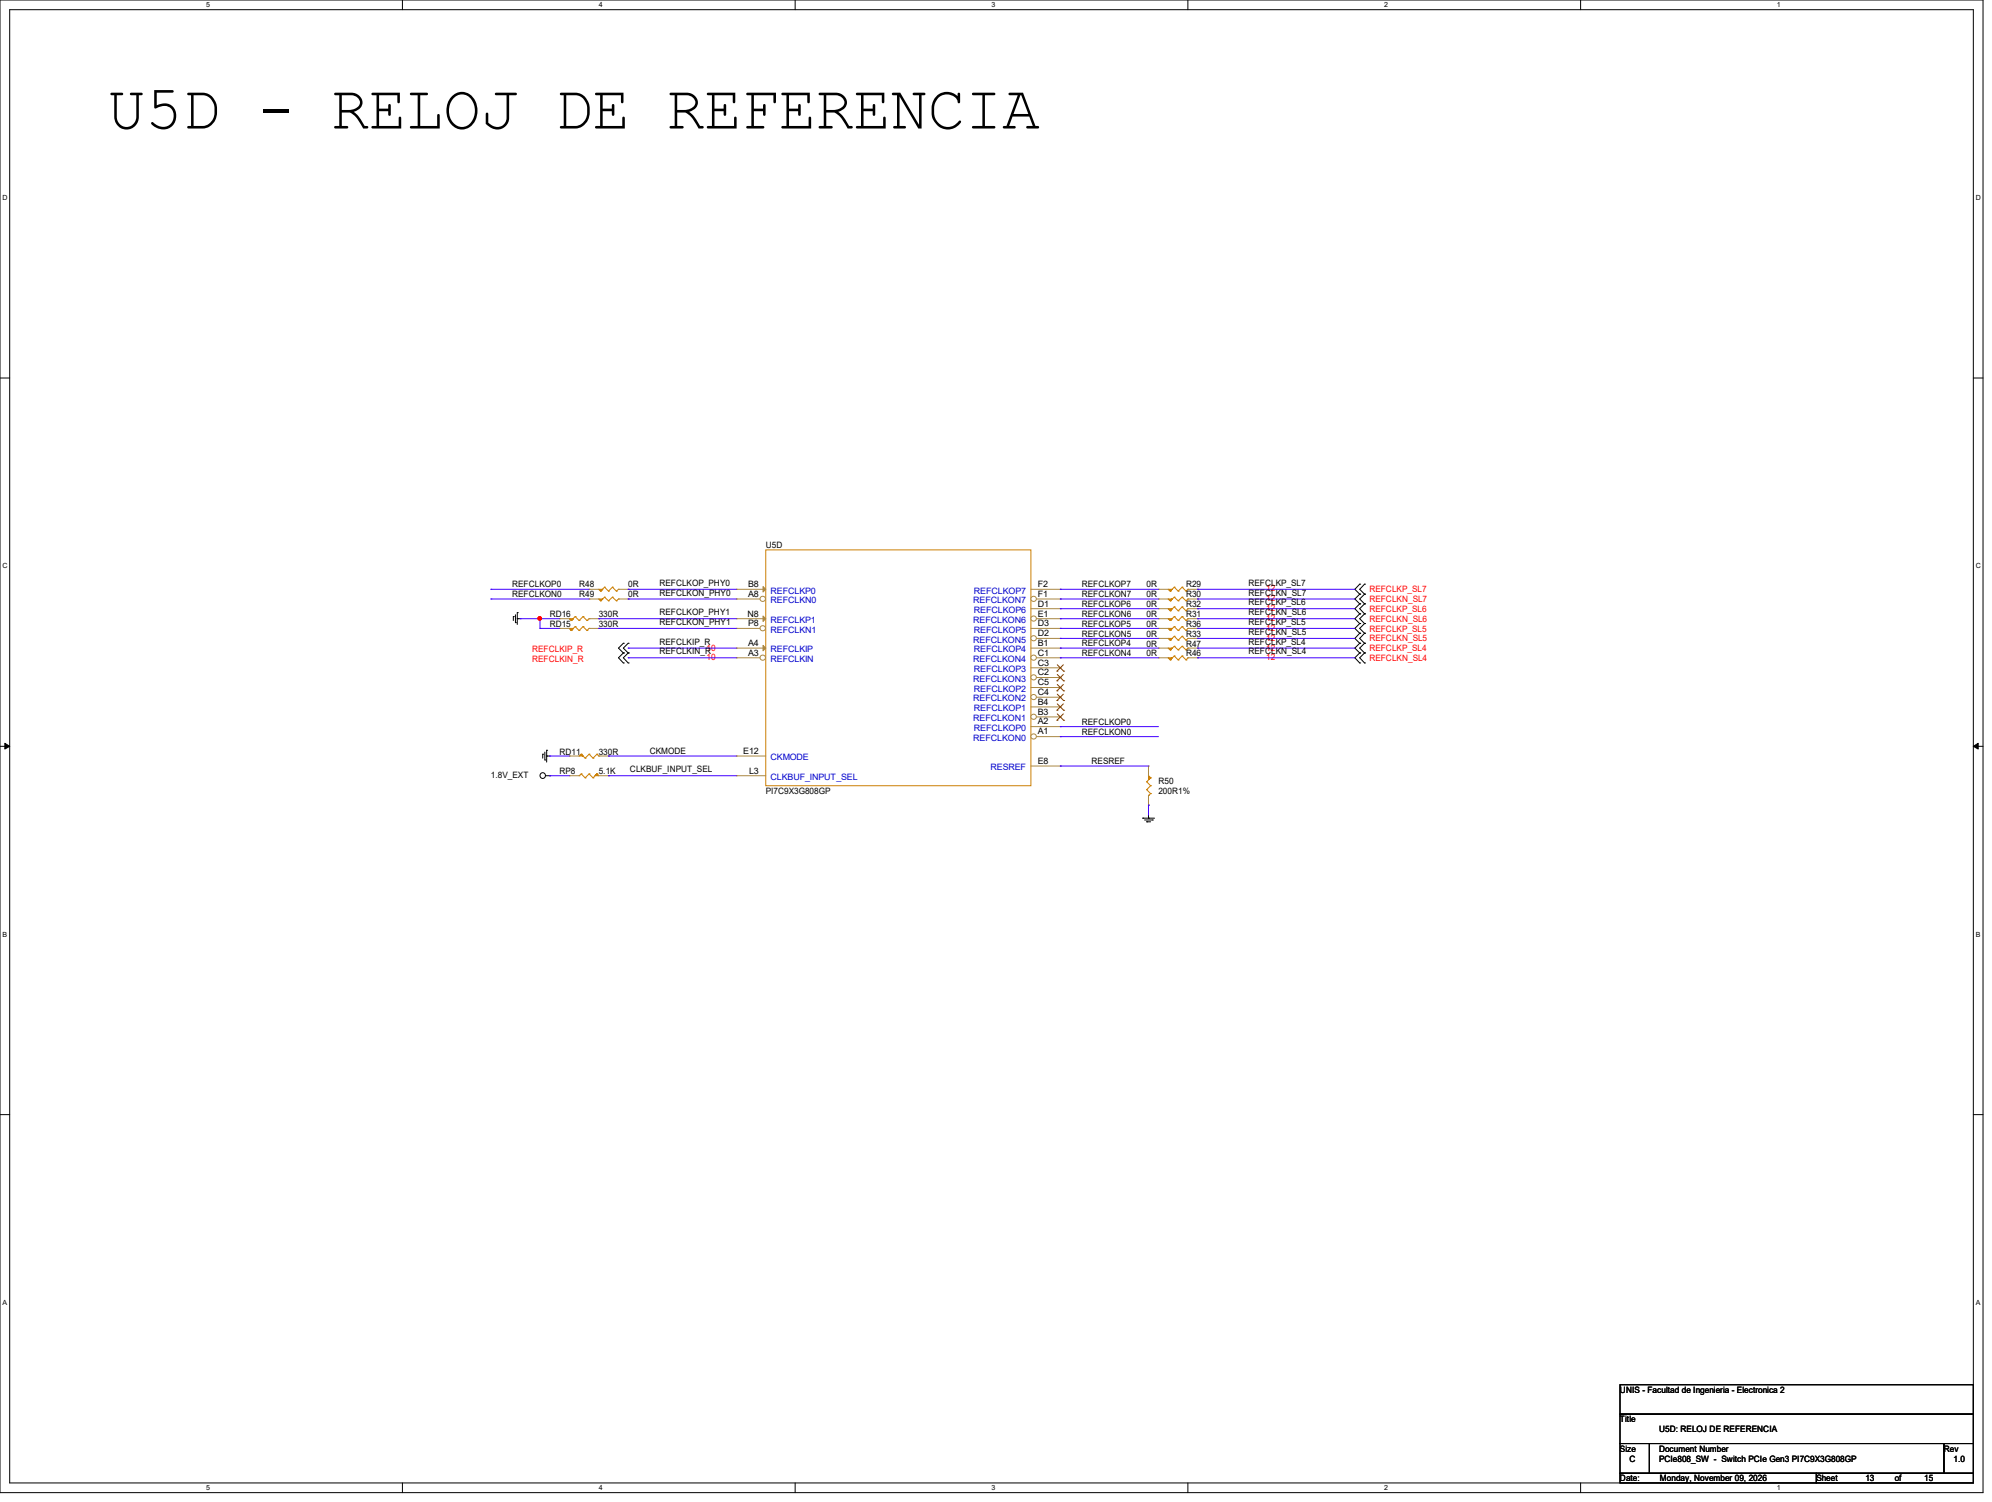
[picture p33: page 13]

# STRAPS DE CONFIGURACION (obligatorios, ver DS43471 sec. 3.2/3.5)

PORTCFG[2:0]=100b: modo 5 puertos (P0 x4 upstream, P4-P7 x1) | I2C_ADDR[2:0]=000 | PM L1.1 y Hot-Plug deshabilitados | Debug mode deshabilitado

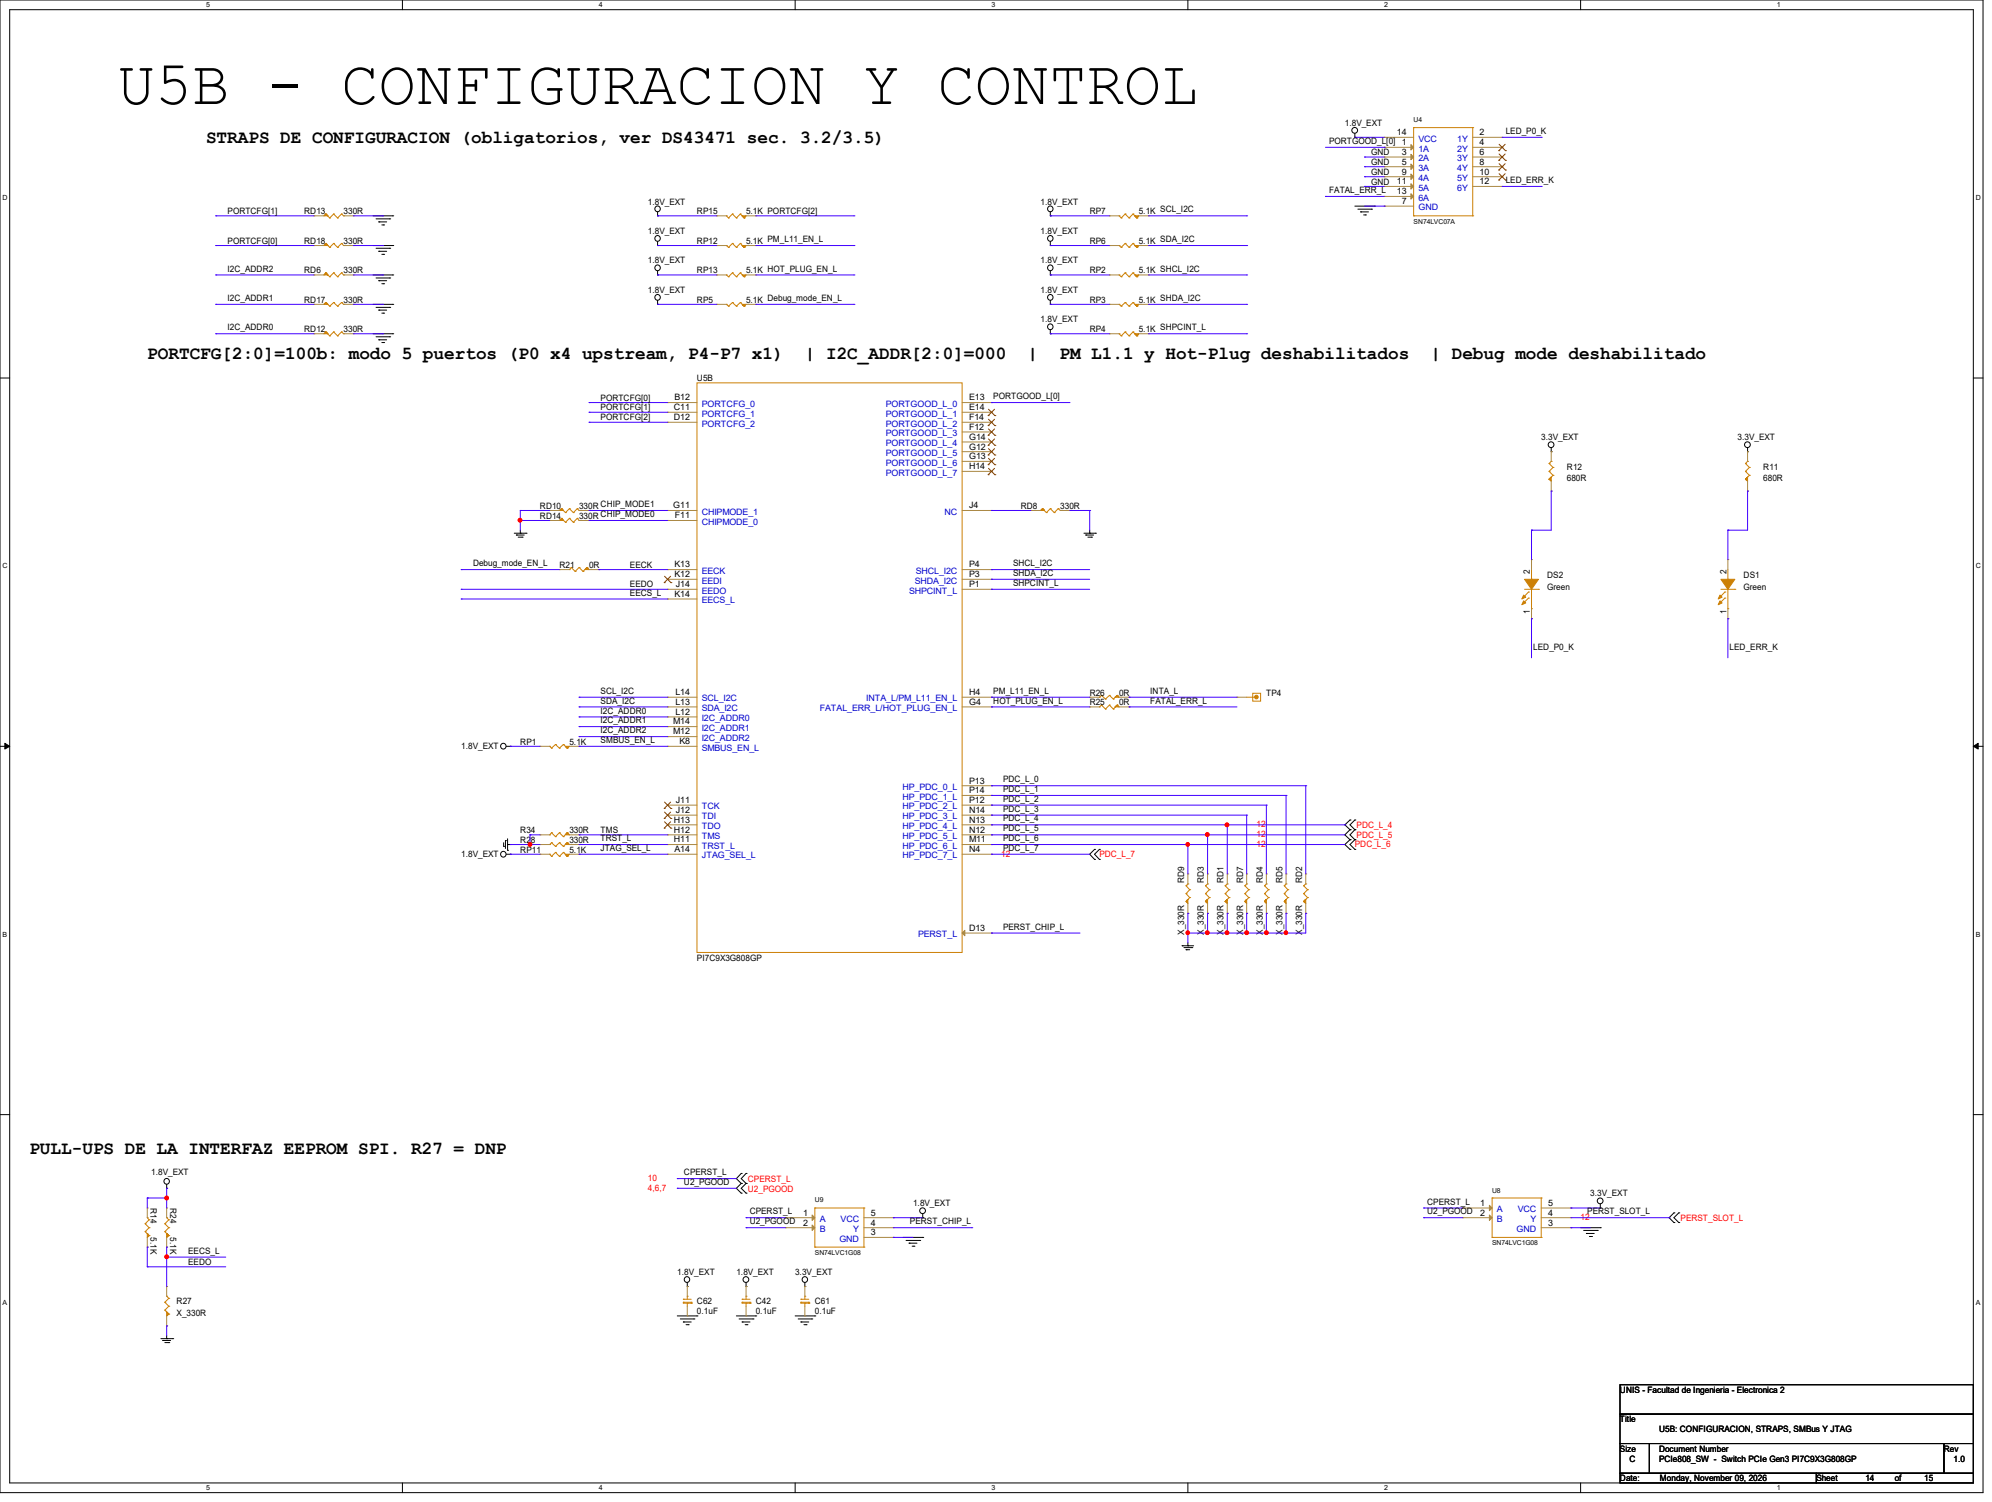
[picture p34: page 14]

INTA_L/PM_L11_EN_L H4 SHDA_I2C P3 SHCL_I2C P4 TCK J11 TDI J12 TDO H13 TMS H12 TRST_L H11

PULL-UPS DE LA INTERFAZ EEPROM SPI. R27 = DNP

# U5E - GPIO

PULL-UPS DE GPIO CON FUNCION ALTERNA: GPIO26=CKBUFPD_L (buffer de reloj activo), GPIO30=PHY_SRAM_BYPASS, GPIO31=SURPRISE_HP

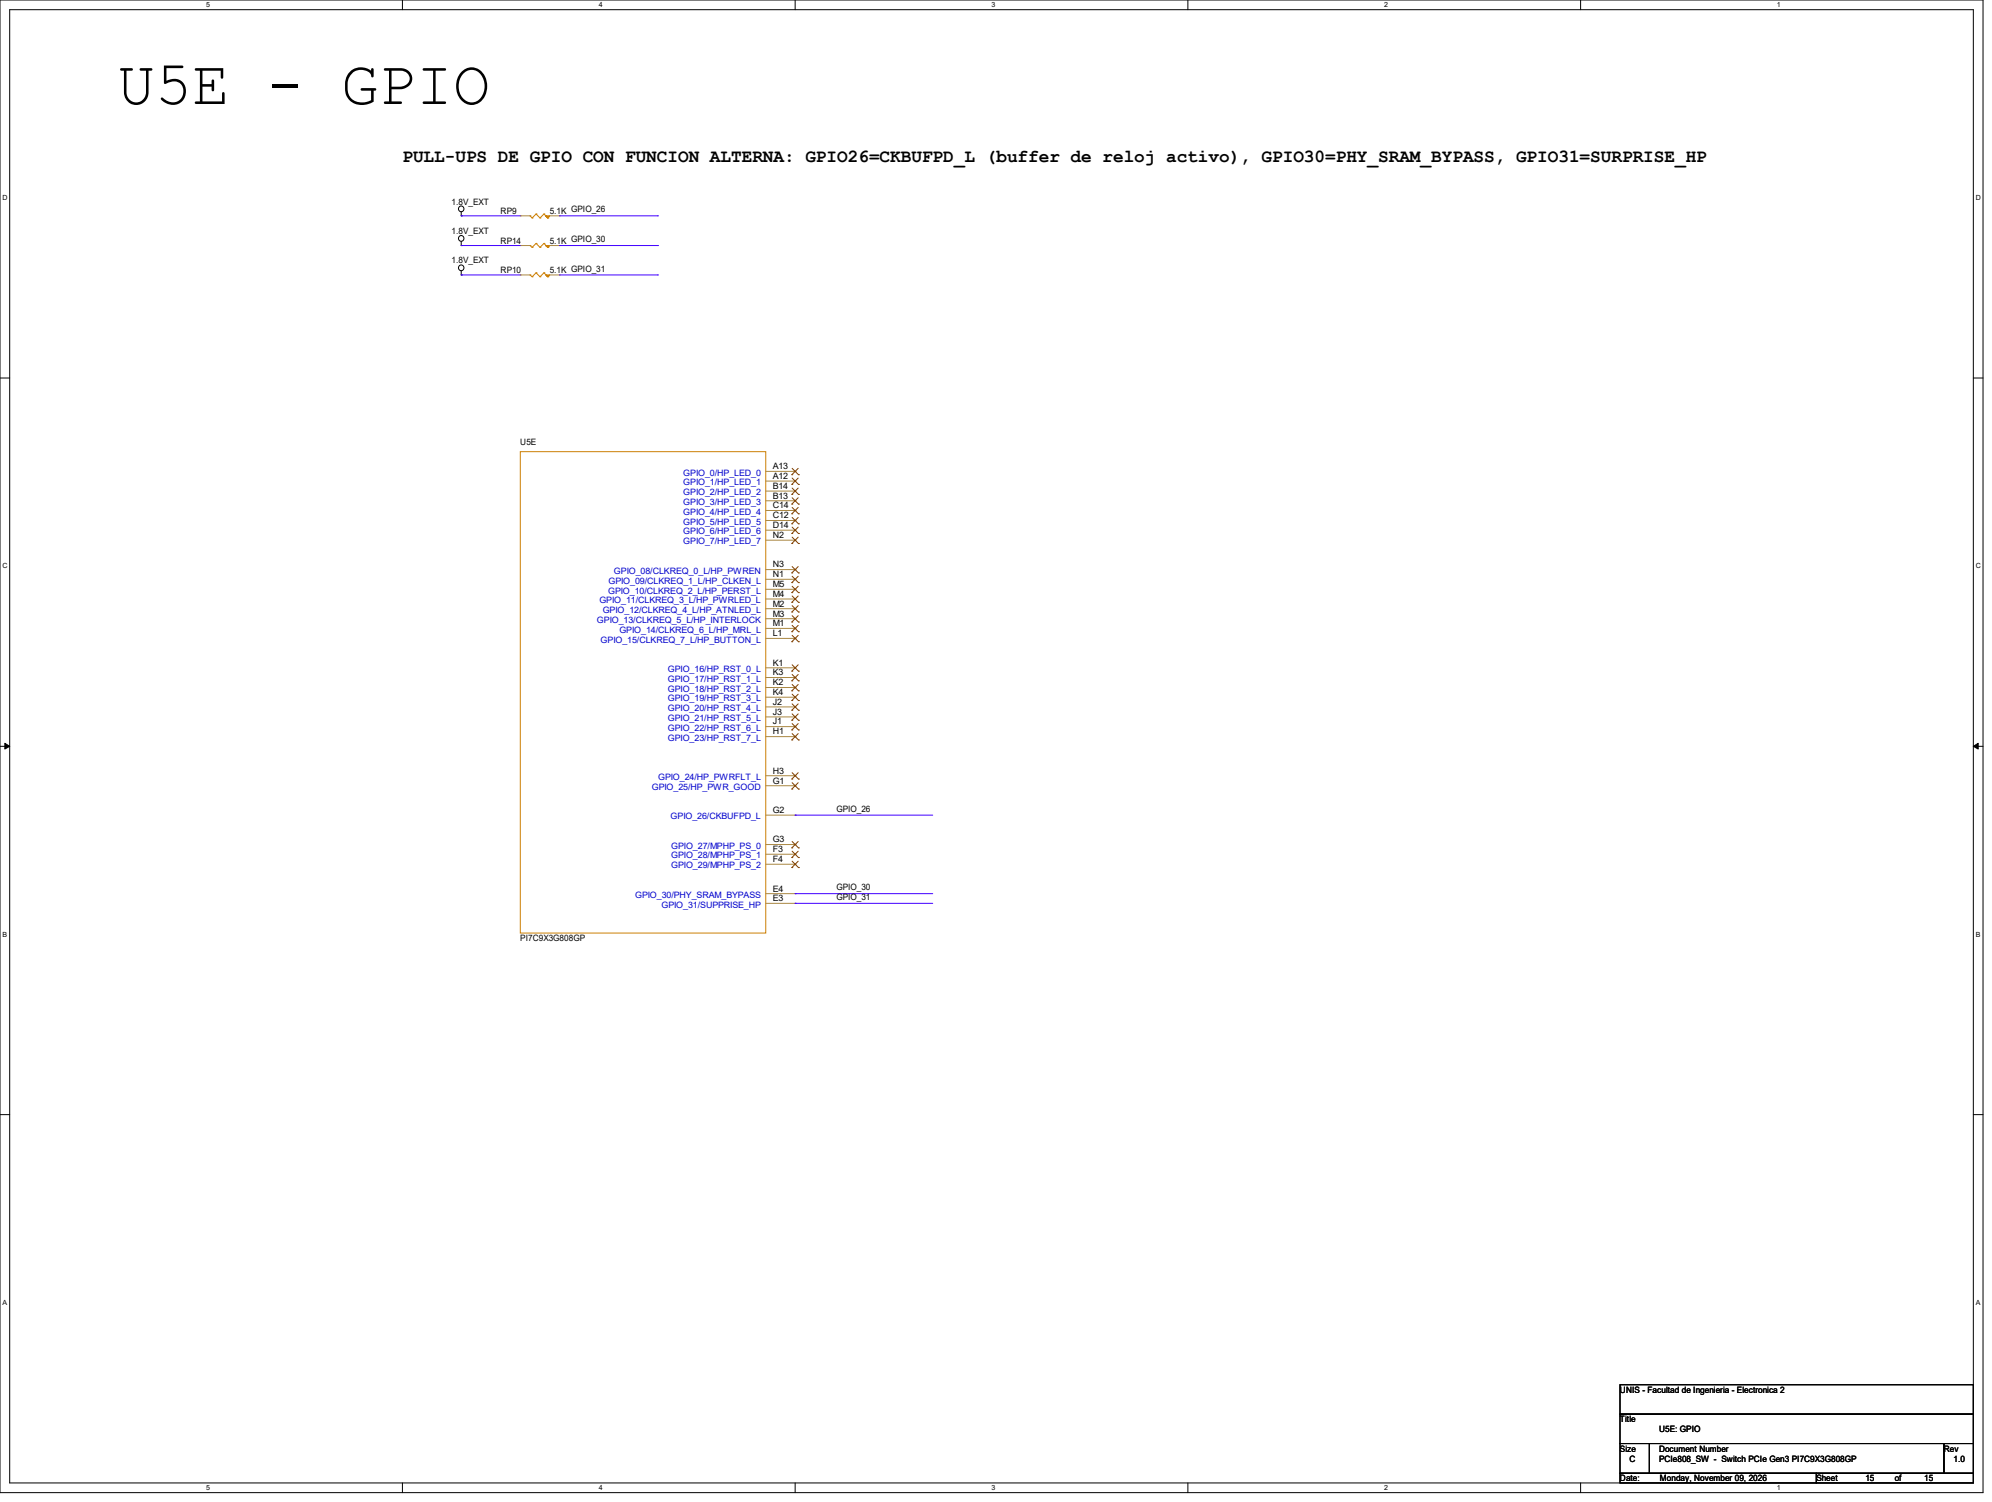
[picture p35: page 15]
