ksflores-cmyk/PCIe808_SW/(list of files, drawings)

Other design files:
PI7_KEVINFLORES.DSN
PI7_KEVINFLORES.opj
