ksflores-cmyk/PCIe808_SW/(commit log)

2026-10-25 Esquematico base del switch PCIe Gen3 PI7C9X3G808GP
    - PI7_KEVINFLORES.opj / .DSN (Capture) y allegro/PI7_KEVINFLORES.brd (antes PI7C9.brd)
    - Esquematico y placa AUN NO sincronizados por netlist (pendiente Fase 3)
    - dbdoctor -check_only: 1 error conocido, shape corrupto en
    PACKAGE GEOMETRY/SILKSCREEN_TOP (349.991 5800.991)-(323.866 5774.866),
    origen del crash de Allegro del 21-oct-2026. Se repara en Fase 3.
    [PI7_KEVINFLORES.DSN, PI7_KEVINFLORES.brd, PI7_KEVINFLORES.opj]
2026-10-25 Convertidores Buck: disenos WEBENCH, simbolos y footprints
    - docs/webench: registros de diseno Buck1 TPS54KB20 (3.3V/15A), Buck2 TPS54J060 (0.95V/4A, setpoint 0.96V), Buck3 TPS62933F (0.95V/1A, FCCM)
    - symbols: footprints Ultra Librarian corregidos con SKILL (RZR0016A: 10 vias-pin y cobre ETCH sin red eliminados; place_bound agregado en RZR/RPG; textos basura removidos)
    - symbols: footprints propios IND_XAL8080/7030/5020 desde land pattern Coilcraft (pads SMD 1.78x7.00, 1.78x6.50, 1.18x4.70 mm)
    - library: simbolos Capture UL de los 3 ICs
    [DRL0008A.stp, RPG0014A.stp, RZR0016A.stp, ind_xal5020.psm, ind_xal7030.psm, ind_xal8080.psm, rpg0014a-mfg.psm, rzr0016a-mfg.psm]
2026-10-25 Etapa de potencia: convertidores Buck en hoja 03_PWR1
    - Buck1 TPS54KB20 12V->3.3V_EXT 15A (XAL8080-681, FCCM 800kHz, PG_3V3)
    - Buck2 TPS54J060 5V->0.95V_VDDC 4A (XAL5020-561, setpoint 0.96V)
    - Buck3 TPS62933F 5V->0.95V_VP 1A (XAL7030-152, 500kHz)
    - Secuencia: PG_3V3 -> EN Buck2 -> U2_PGOOD -> EN Buck3
    - Pines de potencia de simbolos UL convertidos a Passive (sin nets globales)
    [PI7_KEVINFLORES.DSN, PI7_KEVINFLORES.opj]
2026-10-25 Librerias: pines de potencia a Passive y documentacion de los Bucks
    - UL_TPS54KB20/UL_TPS54J060/UL_TPS62933F: pines Power (globales) -> Passive.
    Evita que VIN/PGND/SW de distintos Bucks se unan por nombre al actualizar el cache.
    - docs/webench: refdes y cambios respecto al BOM de WEBENCH (secuenciacion por PG).
    - DRC de Capture: 0 errores en 03_PWR1.
2026-10-25 README: aviso de uso y guia para abrir el proyecto
2026-10-25 Actualizacion de documentacion
2026-10-25 Avance esquematico
    [PI7_KEVINFLORES.DSN, PI7_KEVINFLORES.opj, blkcon100vhtm2oew20032.psm]
2026-10-25 Avance PCB: netlist
    [PI7_KEVINFLORES.DSN, PI7_KEVINFLORES.brd]
2026-10-25 Mejoras librerias PCB
    [c0402.psm, c0402_bga.psm, c0603.psm, c0805.psm, c1206.psm, c1210.psm, head1x3_2_54mm.psm, hfcbga_196_15x15.psm]
2026-10-25 Avance PCB
    [PI7_KEVINFLORES.DSN, PI7_KEVINFLORES.brd, pwr-4p-90.psm]
2026-10-25 Avance PCB: placement
    [PI7_KEVINFLORES.brd]
2026-10-28 mejoras pcb
    [PI7_KEVINFLORES.brd]
2026-10-31 mejoras esquematico
    [PI7_KEVINFLORES.DSN, PI7_KEVINFLORES.brd, PI7_KEVINFLORES.opj]
